nikki-uwu/Meower/info_and_docs/bci-timeline-complete-part2.md

## 16-Channel EEG Acquisition System Development

### Topic Definitions

1. **Hardware Selection** - Component evaluation, chip selection, module comparison
2. **Analog Front-End** - ADS1299 configuration, registers, daisy-chain operation
3. **PCB Design** - Layout, routing, component placement
4. **Power Management** - TX power control, battery monitoring, power optimization
5. **ESP32 Firmware** - Embedded software, FreeRTOS, SPI drivers, core functionality
6. **DSP** - Digital filters (FIR/IIR), signal processing, real-time algorithms
7. **GUI/Visualization** - Python GUI, plotting, user interface, real-time display
8. **Network/Discovery** - UDP communication, WiFi, auto-discovery protocols
9. **BrainFlow Integration** - VRChatBoard driver development, API integration
10. **Documentation** - README, timeline, knowledge base maintenance
11. **Testing/Debug** - Troubleshooting, bug fixes, validation

---

## Chronological Timeline

| Date | Start | End | Duration | Topic(s) | Work Details |
|---|---|-----|---|---|---|
| 2025-07-11 | 14:02:16 | 16:57:29 | 2h 55m | Documentation, Hardware Selection | Claude AI workflow comparison, Python merger script, ESP32-C3 EEG board analysis (75% production ready) |
| 2025-07-11 | 19:39:56 | 21:35:04 | 1h 55m | GUI/Visualization | Python visualization debugging - matplotlib blitting issues, amplitude slider, Entry widgets |
| 2025-07-12 | 13:37:01 | 14:43:14 | 1h 6m | GUI/Visualization | Code update guidance, blitting technique with marked dynamic artists |
| 2025-07-12 | 15:50:35 | 18:45:11 | 2h 55m | GUI/Visualization | GUI plot duration updates, SignalWorker buffer resizing, StringVar/Entry desync fix, code rules |
| 2025-07-12 | 22:25:34 | 23:58:31 | 1h 33m | GUI/Visualization, DSP | Signal amplitude 3.17x (6dB PGA gain), optimized 24-bit parser vectorization |
| 2025-07-13 | 00:01:51 | 01:03:19 | 1h 1m | GUI/Visualization | PlotManager extraction from monolithic main_gui.py (1800→850 lines) |
| 2025-07-13 | 16:25:39 | 19:17:20 | 2h 52m | GUI/Visualization, DSP | NFFT power-of-2 removal, max-hold feature, time delta plot (8μs timestamps) |
| 2025-07-13 | 21:10:20 | 22:33:35 | 1h 23m | GUI/Visualization | Channel selector wavelets/spectrogram, 95% overlap, power limit sliders |
| 2025-07-14 | 00:04:02 | 00:13:01 | 0h 9m | GUI/Visualization | NERV/Evangelion aesthetic redesign - amber on black |
| 2025-07-14 | 07:59:01 | 08:38:48 | 0h 40m | GUI/Visualization | Semi-transparent orange panels, borderless entries, gradient sliders |
| 2025-07-14 | 13:50:43 | 14:10:07 | 0h 19m | GUI/Visualization | Fixed ttk widget bg errors, GradientScale implementation |
| 2025-07-15 | 01:03:36 | 03:56:51 | 2h 53m | GUI/Visualization, Analog Front-End | Signal slider colors, IIR filter states, DC filtering, ADS1299 slave registers |
| 2025-07-15 | 13:33:15 | 15:09:51 | 1h 37m | BrainFlow Integration | VRChatBoard implementation, config_board(), debug mode, auto-discovery |
| 2025-07-15 | 18:20:40 | 19:53:49 | 1h 33m | BrainFlow Integration, Network/Discovery | Auto-discovery beacons, UDP socket port 5000 binding fix |
| 2025-07-16 | 17:54:38 | 23:27:07 | 5h 33m | BrainFlow Integration, GUI/Visualization | Debug message removal, thread safety, ASCII cleanup, real-time plotting 1-sec window |
| 2025-07-17 | 00:00:34 | 00:36:36 | 0h 36m | BrainFlow Integration | Python debugging config, BoardShim.enable_dev_board_logger() |
| 2025-07-17 | 02:53:09 | 07:44:01 | 4h 51m | BrainFlow Integration | Timestamp channel, keep-alive mechanism, thread management, fallback settings |
| 2025-07-18 | 02:41:26 | 07:30:07 | 4h 49m | BrainFlow Integration, DSP | ESP32 board integration, UDP frame parsing, digital filter state reset |
| 2025-07-18 | 08:28:43 | 11:48:24 | 3h 20m | Documentation | Git submodule strategy, pip installation from GitHub |
| 2025-07-19 | 18:15:15 | 18:16:40 | 0h 1m | Hardware Selection | 16-channel EEG board market research |
| 2025-07-19 | 19:06:38 | 23:48:16 | 4h 42m | ESP32 Firmware, Network/Discovery | ESP32 data acquisition review, MEOW_MEOW/WOOF_WOOF protocol, auto IP |
| 2025-07-19 | 23:52:02 | 23:57:33 | 0h 6m | ESP32 Firmware | Auto IP discovery final verification |# BCI Project Complete Timeline
| 2025-07-20 | 00:25:10 | 00:27:09 | 0h 2m | Documentation | GitHub repository privacy settings |
| 2025-07-20 | 17:03:15 | 17:14:57 | 0h 12m | ESP32 Firmware | "floof" references cleanup to "WOOF_WOOF" |
| 2025-07-21 | 02:54:06 | 07:57:02 | 5h 3m | Hardware Selection, Documentation | BCI market analysis, OpenBCI sales, profit calculations |
| 2025-07-21 | 23:57:36 | 23:57:54 | 0h 0m | Testing/Debug | SPI message generation script |
| 2025-07-22 | 00:05:43 | 00:22:23 | 0h 17m | Analog Front-End | SPI message format, ADS1299 ID register values |
| 2025-07-22 | 22:17:58 | 22:20:14 | 0h 2m | GUI/Visualization | Serial console IP configuration removal |
| 2025-07-23 | 22:42:44 | 23:37:14 | 0h 55m | Analog Front-End | ADS1299 SPI interface design, daisy-chain register reading |
| 2025-07-24 | 00:01:12 | 02:24:17 | 2h 23m | ESP32 Firmware, Analog Front-End | Adaptive frame packing, linker error fix, code audit |
| 2025-07-24 | 02:26:10 | 04:22:27 | 1h 56m | ESP32 Firmware | SPI clock management, USR commands, signal graph updates |
| 2025-07-24 | 09:32:26 | 09:39:57 | 0h 8m | Documentation | ESP32-C3 EEG firmware artifacts creation |
| 2025-07-24 | 18:42:55 | 19:37:41 | 0h 55m | Documentation | Documentation refinement, README/KB updates |
| 2025-07-24 | 21:32:36 | 23:55:31 | 2h 23m | ESP32 Firmware, Analog Front-End | USR commands implementation, ADC sampling frequency control |
| 2025-07-25 | 00:00:53 | 01:12:25 | 1h 12m | ESP32 Firmware, Analog Front-End | Hardware PGA gain control, channel power control |
| 2025-07-25 | 10:35:00 | 12:54:04 | 2h 19m | ESP32 Firmware, Documentation | Messages_lib optimization, helper functions, licensing strategy |
| 2025-07-25 | 20:25:05 | 21:47:13 | 1h 22m | Documentation | Open source licensing implementation, project verification |
| 2025-08-07 | 00:49:13 | 02:44:36 | 1h 55m | GUI/Visualization | Tkinter Python 3.11/3.12 compatibility, Entry widget sync |
| 2025-08-07 | 05:53:57 | 08:13:05 | 2h 19m | GUI/Visualization, ESP32 Firmware | Window grab issues, dependency verification, board startup analysis |
| 2025-08-07 | 10:48:16 | 13:06:49 | 2h 19m | ESP32 Firmware, Power Management | WiFi TX power ramping (2dBm→11dBm), flash erase automation, AP mode |
| 2025-08-07 | 20:19:07 | 23:17:51 | 2h 59m | GUI/Visualization | GUI compatibility, VRCMarker optimization, TimelineController fixes |
| 2025-08-08 | 11:41:33 | 12:12:55 | 0h 31m | BrainFlow Integration | VRChat board logging modification, debug output |
| 2025-08-12 | 05:21:29 | 05:51:30 | 0h 30m | GUI/Visualization | BrainFlow real-time plotting, dual subplot display |
| 2025-08-13 | 01:35:05 | 05:58:21 | 4h 23m | Documentation | BCI timeline recovery, verification, code comparison |
| 2025-08-13 | 05:30:24 | 08:35:24 | 3h 5m | Documentation | ChatGPT JSON compression, timeline extraction strategies |
| 2025-08-13 | 08:06:59 | 08:35:24 | 0h 28m | Documentation | Project timeline recovery analysis (merged with above) |
| 2025-08-18 | 07:17:28 | 07:47:08 | 0h 30m | Documentation | HTML infographic creation, visual calendar fixes |

---

## Summary Statistics

### Total Time by Topic

| Topic | Total Duration |
|---|---|
| GUI/Visualization | 30h 34m |
| Documentation | 24h 30m |
| ESP32 Firmware | 19h 45m |
| BrainFlow Integration | 19h 30m |
| Analog Front-End | 10h 3m |
| DSP | 9h 14m |
| Hardware Selection | 7h 59m |
| Network/Discovery | 6h 15m |
| Power Management | 2h 19m |
| Testing/Debug | 0h 0m |
| PCB Design | 0h 0m |

**Note: Sessions with multiple topics are counted for each topic**

### **ACTUAL TOTAL WORK TIME: 87h 42m**

---

## Key Achievements
- **July 11**: Migration to Claude, 75% production assessment
- **July 13**: PlotManager extraction (clean architecture)
- **July 14**: NERV/Evangelion GUI theme
- **July 15**: BrainFlow VRChatBoard driver
- **July 19**: MEOW_MEOW/WOOF_WOOF protocol
- **July 24-25**: Complete USR command family
- **August 7**: WiFi TX power ramping fix (2→11dBm)
- **August 13**: Complete timeline recovery

### Issues Status
1. **UDP dropout race** - Still present
2. **Timestamp rollover (9.5h)** - Not fixed
3. **Filter Q=35** - Fixed
4. **WiFi TX oversaturation** - Fixed (Aug 7)
5. **Python 3.11/3.12 compatibility** - Fixed
6. **BrainFlow upstream merge** - Pending

### Production Readiness: 85%
