nikki-uwu/Meower/info_and_docs/eeg-firmware-knowledge-base.md

# ESP32-C3 EEG Firmware Complete Knowledge Base

This document consolidates ALL technical knowledge, implementation details, and important notes scattered throughout the firmware codebase. Created to prevent getting lost in the massive codebase.

---

## 🔴 Critical Safety & Performance Rules

1. **ALWAYS use battery power during recording** - USB introduces catastrophic noise that destroys µV-level signals
2. **Never exceed 2 MHz SPI during initial configuration** - ADS1299 refuses faster clocks after reset
3. **Keep ADC sense pin on ADC1 only** - ADC2 conflicts with WiFi and will cause crashes
4. **Quad-tap power for recovery** - If board acts dead, 4 power cycles < 5s cumulative triggers captive portal
5. **Send "WOOF_WOOF" every ≤10 seconds** - Board drops to IDLE after 10s without keep-alive
6. **SPI/USR commands stop streaming** - Any SPI or USR command via WiFi immediately stops continuous mode because ADS1299 can't receive register commands during continuous data mode

---

## 1. Hardware Architecture & Pin Mapping

### ESP32-C3 Pin Assignments
```
SCLK        : GPIO 10  (Hardware SPI)
MOSI        : GPIO 6   (Hardware SPI)
MISO        : GPIO 2   (Hardware SPI + pulldown to prevent tri-state decay)
DRDY        : GPIO 3   (Interrupt pin, FALLING edge)
START       : GPIO 0   (Controls ADC sampling)
PWDN        : GPIO 8   (Power down control)
RESET       : GPIO 7   (Hardware reset)
CS_MASTER   : GPIO 1   (Master ADS1299)
CS_SLAVE    : GPIO 5   (Slave ADS1299)
CS_UNUSED   : GPIO 21  (Default SPI CS - kept HIGH)
LED         : GPIO 20  (Status indicator, active LOW)
BAT_SENSE   : GPIO 4   (ADC1_CH4 - CRITICAL: Must be ADC1!)
```

### Daisy-Chain Configuration
- **Data flow**: Slave ADC output → Master ADC input → ESP32
- **Clock**: Master provides clock to Slave via dedicated line
- **Sync**: Both ADCs share START signal for perfect alignment
- **Frame structure**: 27 bytes per ADC (3 preamble + 24 channel data)

### Electrical Design Notes
- **Battery voltage divider**: Calibrated scale factor = 0.001235 (current implementation)
- **Battery monitoring**: Sampled every 32ms with IIR filter (α=0.05) for stable readings
- **Pull-down on MISO**: Prevents signal decay when last bit = 1
- **CS timing**: Uses direct register writes (40ns edges) vs digitalWrite (1.2µs)
- **Power**: ~400mW typical, 470mW max @ 4kHz
- **PGA Gain**: Voltage amplification in analog domain before ADC conversion
- **DC Offset Warning**: Check DC voltage between input pins before setting gain - small signals on DC offsets will saturate when amplified
- **Data format**: Channel data in big-endian, timestamps and battery voltage in little-endian
- **CPU locked to 160MHz**: At 80MHz there's not enough headroom for 4kHz processing despite only +30mW difference

### TX Power Management
- **Initial power**: Starts at 2dBm to prevent RF oversaturation during initialization
- **Operational power**: Increases to 11dBm for normal operation after WiFi/AP setup
- **Sequence**: Low power → Initialize → Configure → Increase to operational level

---

## 2. Boot Sequence & Recovery Mechanisms

### BootCheck System (Anti-Brick Protection)
```
Window: 5 seconds cumulative ON time
Detection: 3 reboots with flag="a" (armed) within window
Action: Set BootMode="AccessPoint" → force captive portal
Reset: After 1 second, flag changes "a"→"b" (disarmed)
```

### Captive Portal Emergency Mode
- **SSID**: `EEG-SETUP`
- **Password**: `password`  
- **IP**: `192.168.4.1`
- **Saves to NVS**: ssid, pass, port_ctrl, port_data
- **Auto-triggers**: On missing config or boot storm

### ADS1299 Initialization Sequence
1. Set continuous mode OFF
2. Force SPI to 2 MHz (CRITICAL for stability)
3. All digital signals LOW (CS, START)
4. PWDN/RESET cycle with 150ms delays
5. Send RESET pulse (10µs LOW)
6. SDATAC command (exit continuous mode)
7. Enable internal reference (CONFIG3 = 0xE0)
8. Configure master clock output to slave
9. **Wait 50ms for slave clock lock** - CRITICAL: Slave ADC needs time to lock onto master's clock signal
10. Enable test signal (1Hz square wave)
11. Board initializes at 250 Hz with 5-frame packing (50 packets/sec)
12. SPI remains at 2 MHz until `sys start_cnt` switches to 16 MHz
13. **Default channel settings**:
    - Normal mode: Test signal input, gain = 1x (register value 0x05)
    - BCI mode: Normal electrode input with SRB2, gain = 1x (register value 0x08)

### Readiness Check
```c
// Loop until ADS1299 responds with correct ID
while (true) {
    xfer('M', 3, {0x20, 0x00, 0x00}, rx);  // Read register 0x00
    if (rx[2] == 0x3E) break;               // Expected device ID
    delay(10);
}
```

---

## 3. Network Architecture & Lifecycle

### State Machine
```
DISCONNECTED → (WiFi connect) → IDLE → (start_cnt) → STREAMING
     ↑              ↑                        ↓
     └──────────────┴──── (timeout/stop) ───┘
```

### Discovery & Keep-Alive Protocol
1. **Board broadcasts**: "MEOW_MEOW" (9 bytes) to 255.255.255.255 on control port every 1 second when no PC found
2. **PC responds**: Sends "WOOF_WOOF" to board's IP on control port
3. **Board captures PC IP**: First WOOF_WOOF saves source IP as PC address
4. **Keep-alive required**: PC must send "WOOF_WOOF" every <10 seconds to maintain connection
5. **Connection lost**: If no WOOF_WOOF for 10 seconds, board drops to IDLE and restarts MEOW_MEOW broadcasts

**Notes**:
- Control port is configurable (default 5000)
- Board ignores its own MEOW_MEOW echoes
- Any valid packet refreshes watchdog (WOOF_WOOF, commands) except MEOW_MEOW echoes
- Keep-alive is "WOOF_WOOF" (no trailing space or other variations)

### Timeout Hierarchy
1. **10s streaming watchdog**: No data → drop STREAMING to IDLE
2. **10s global silence**: No packets at all → restart beacons
3. **60s reconnect limit**: WiFi keeps failing → radio OFF, LED=LOST

### LED Status Codes (250ms on, 5s cycle)
- **Rapid flash**: Network setup mode (AP active)
- **3 blinks**: Cannot connect to WiFi (DISCONNECTED)
- **2 blinks**: Connected but IDLE
- **1 blink**: STREAMING data
- **5 blinks**: Connection LOST (failsafe triggered)

### AsyncUDP Implementation
- **TX**: Traditional WiFiUDP for sending
- **RX**: Event-driven AsyncUDP (zero polling overhead)
- **Queue**: 8-slot command queue, 512 bytes each
- **Beacon filter**: Ignores own MEOW_MEOW beacons

---

## 4. Data Path Architecture

### Frame Structure (52 bytes)
```
[48 bytes ADC data][4 bytes timestamp]
    ↓                    ↓
16 ch × 3 bytes      Little-endian
Big-endian 24-bit    8µs timer units
```

### Packet Structure (max 1472 bytes)
```
[Frame 1][Frame 2]...[Frame N][Battery Voltage]
52 bytes  52 bytes    max 28   4 bytes float32 LE
```

### Task Architecture
1. **DRDY ISR** (IRAM): ~5µs to notify ADC task
2. **ADC/DSP Task** (Priority MAX-1, Core 0):
   - Triggered by task notification (not semaphore - 45% faster)
   - Reads 54 bytes via SPI DMA
   - Strips preambles (saves 6 bytes)
   - Unpacks 24→32 bit with +8 bit headroom
   - Runs DSP pipeline (FIR + IIRs)
   - Packs back to 24-bit
   - Queues complete packet

3. **UDP Task** (Priority MAX-2, Core 0):
   - Blocks on 5-slot queue
   - Appends battery voltage
   - Sends via WiFi

### Queue Design
- **5 slots**: Each holds one complete data packet (up to 28 ADC frames with timestamps)
- **ADC never blocks**: If queue full, skips enqueue and continues processing
- **WiFi headroom**: 5 buffered packets allow WiFi to recover from hiccups without data loss
- **FIFO order**: Guaranteed by FreeRTOS

### Adaptive Packet Sizing

The firmware dynamically adjusts frames per packet to target 50 packets/second over WiFi:

**Hardware Constraints**:
1. **MTU Limit**: 1472 bytes usable → max 28 frames (28*52+4=1460 bytes)
2. **WiFi Timing**: ESP32 needs ~6ms between packets → max ~166 packets/sec
   - This is a hardware/driver limitation of the ESP32 WiFi stack
   - Pushing faster causes packet drops and instability

**Implementation**:
- Lookup table in `FRAMES_PER_PACKET_LUT[5]` maps sampling rate to frame count
- Updated when sampling rate changes in `continuous_mode_start_stop()`
- Variables updated:
  - `g_framesPerPacket`: How many frames to pack
  - `g_bytesPerPacket`: ADC data size threshold  
  - `g_udpPacketBytes`: Total UDP payload size (includes battery)

**Packing Strategy**:
| Rate | Frames | Result |
|---|---|---|
| 250 Hz | 5 | 50 packets/sec |
| 500 Hz | 10 | 50 packets/sec |
| 1000 Hz | 20 | 50 packets/sec |
| 2000 Hz | 28 | 71 packets/sec (MTU limit) |
| 4000 Hz | 28 | 143 packets/sec (MTU limit) |

**Why This Matters**:
- 250 Hz unpacked = 250 pkt/s → WiFi overload
- 250 Hz with 5-frame packing = 50 pkt/s → smooth operation
- 4000 Hz would need 4000 pkt/s unpacked → impossible
- 4000 Hz with 28-frame packing = 143 pkt/s → just under limit

---

## 5. Digital Signal Processing Pipeline

### Overview
All processing runs at 160MHz with fixed-point math. Global enable + individual filter enables.

### Complete Processing Chain (Sequential, In-Place)
```
Input (54 bytes) → [ADC Parse] → [<<8 shift] → [Digital Gain] → [FIR Equalizer] → [DC Blocker] → [Notch 50/60] → [Notch 100/120] → [>>8 shift] → Output (48 bytes)
                      ↓              ↓              ↓                ↓                ↓               ↓                  ↓               ↓
                 Remove preambles  24→32 bits    Bit shift      Optional        Optional        Optional          Optional         32→24 bits
```

### Processing Steps:

1. **ADC Sample Parsing**: Strip two 3-byte preambles from raw 54-byte frame (27 bytes per ADC) to get 48 bytes of channel data

2. **Bit Shift Up (+8)**: Convert 24-bit to 32-bit with 8-bit headroom for DSP

3. **Digital Gain**: Additional bit shifting (0-8 bits) for signal amplification
   - Reduces maximum input range before saturation:
     - Gain 1: ±4.5V (full ADC range)
     - Gain 8: ±562.5mV
     - Gain 16: ±281.25mV

4. **FIR Equalizer (7-tap)**:
   - Purpose: Compensates ADS1299 sinc³ decimation rolloff
   - Response: Flat ±0dB from DC to 0.8×Nyquist
   - Shift: 30 bits output scaling
   - Bypass: True pass-through coefficients

5. **DC Blocker (2nd order Butterworth IIR)**:
   - Cutoffs: 0.5, 1, 2, 4, 8 Hz (runtime selectable)
   - Coefficient sets: 25 (5 sample rates × 5 cutoffs)
   - Note: 0.5Hz cutoff @ 4kHz sampling can become unstable (resonator behavior)

6. **Notch Filters (4th order, cascaded biquads)**:
   - 50/60 Hz: Q≈35, -40dB rejection (NOT Q=50 as sometimes incorrectly stated)
   - 100/120 Hz: Same specs for harmonics
   - Coefficient sets: 10 each (5 rates × 2 regions)

7. **Bit Shift Down (-8)**: Convert back from 32-bit to 24-bit for transmission

### Filter Math Details
- **Data type**: int32_t[16] throughout
- **Signal scaling**: All signals get +8 bit shift (24→32 bits) to occupy more of the dynamic range for filter precision
  - This is fixed 8-bit shift, not adaptive scaling
  - Critical for filter stability at extreme settings (0.5Hz @ 4kHz)
  - Without this, filters can break and add DC instead of removing it
- **Rounding**: Away from zero to prevent DC bias
- **Headroom**: All stages stay within ±31 bits
- **Reset**: Toggle off→on clears IIR states (takes ~9 samples for full clear due to filter depth)
- **Coefficient generation**: Python script included as comments in math_lib.h

### Important IIR Filter Behavior
**Problem**: Large spikes can cause ringing (phantom oscillations)
**Solution**: `sys filters_off` → `sys filters_on` resets states
**Timing**: State reset is immediate, but takes ~9 samples for complete clear due to filter depth

### Runtime Filter Control
- **SYS commands work during streaming**: Filters toggle in real-time without stopping data
- **Filter changes are immediate**: No need to stop/restart streaming
- **Each filter has individual control**: Can enable/disable specific filters while others run

---

## 6. SPI Communication Layer

### Clock Management (CENTRALIZED)

**Critical**: `continuous_mode_start_stop()` is the **ONLY** function that:
- Changes SPI clock speeds (2 MHz ↔ 16 MHz)
- Controls continuous mode state (START signal + RDATAC/SDATAC commands)
- Ensures proper state for all register operations

**Clock States**:
```c
Configuration: 2 MHz (when continuousReading == false)
Streaming:     16 MHz (when continuousReading == true)
Mode:          SPI_MODE1 (CPOL=0, CPHA=1)
```

**Why Different Speeds?**:
- **2 MHz for configuration**: ADS1299 register operations become unstable above 4 MHz
- **16 MHz for streaming**: Maximum stable speed for continuous data transfer

**Clock Invariant**: All functions can assume the correct clock is already set based on continuous mode state

### Chip Select Control
- **Method**: Direct register writes via WRITE_PERI_REG
- **Timing**: 40ns edges (vs 1.2µs for digitalWrite)
- **Sync**: Both CS lines toggle simultaneously
- **Delays**: 2µs after CS LOW, 2µs before CS HIGH

### Critical Transfer Function
```c
void xfer(target, length, txData, rxData) {
    portENTER_CRITICAL();      // Block ALL interrupts
    cs_both_high();            // Ensure clean state
    
    switch(target) {
        'M': cs_master_low();  // Master only
        'S': cs_slave_low();   // Slave only  
        'B': cs_both_low();    // Both ADCs
        'T': break;            // Test mode (no CS)
    }
    
    esp_rom_delay_us(2);       // ≥4 SPI clocks
    transferBytes();           // DMA burst
    esp_rom_delay_us(2);       // ≥4 SPI clocks
    cs_both_high();            // Deselect
    portEXIT_CRITICAL();
}
```

### Daisy-Chain Register Reading
Reading registers from both ADCs simultaneously is implemented via `read_Register_Daisy()`:
- Uses target 'B' (both chips selected)
- Sends 30-byte transaction
- Master register value at byte 3
- Slave register value at byte 30
- **Used internally by usr commands** but not exposed as simple SPI command
- **usr gain/ch_power_down/ch_input/ch_srb2 commands** all use this internally when targeting specific channels

### Daisy-Chain Register Read Protocol

In daisy-chain mode, reading registers requires special handling because both ADCs are connected in series. The slave's data output feeds into the master's data input, and the ESP32 only reads from the master.

**Why 30 bytes?**
When reading a single register in daisy-chain mode:
- Each ADC outputs 27 bytes total (3 header bytes + 24 channel data bytes)
- For register reads, only the 3rd byte of each ADC's response contains the actual register value
- Master's register value appears at byte position 3 (0-indexed: rx[2])
- Slave's register value appears at byte position 30 (0-indexed: rx[29])
- We only need to clock out 30 bytes to retrieve both register values

**Protocol Requirements**:
1. **Must select both chips simultaneously** - Using target 'B' is mandatory. If only one chip is selected, the daisy chain breaks and data becomes corrupted
2. **Must use configuration clock** (2 MHz) - ADS1299 requires slower clock for register operations
3. **Cannot read different registers** from each ADC in one transaction - both receive the same command
4. **Response order is fixed** - Slave data always arrives first, then Master data
5. **Timing is critical** - The 2µs delays after CS changes ensure proper setup/hold times

---

## 7. Command Protocol

### Format
- **Transport**: UDP port 5000 (default)
- **Encoding**: UTF-8 strings
- **Termination**: Not required (packet boundary)

### Command Safety
**Command Behavior During Continuous Mode**:
- **SYS commands**: Execute without interrupting data flow. Filters, digital gain, network settings update in real-time
- **SPI and USR commands**: Automatically stop continuous mode before executing because:
  - ADS1299 cannot receive register commands during continuous data mode (RDATAC)
  - Must exit to command mode (SDATAC) first
  - Requires 2 MHz clock for stable register operations
- **Clock Speed Rationale**: Register operations above 4 MHz unstable, streaming uses 16 MHz for throughput

### System Commands (Can be used during continuous mode)
```
sys start_cnt         Start streaming
sys stop_cnt          Stop streaming
sys adc_reset         Full ADC reset + sync (stops continuous mode)
sys esp_reboot        Complete reboot (stops continuous mode)
sys erase_flash       Wipe config → AP mode (stops continuous mode)

sys filters_on/off    Master filter switch (real-time)
sys filter_equalizer_on/off  (real-time)
sys filter_dc_on/off        (real-time)
sys filter_5060_on/off      (real-time)
sys filter_100120_on/off    (real-time)

sys networkfreq 50|60       (real-time)
sys dccutofffreq 0.5|1|2|4|8  (real-time)
sys digitalgain 1|2|4|8|16|32|64|128|256  (real-time)
```

### User Commands (Stop continuous mode before executing)
```
usr set_sampling_freq 250|500|1000|2000|4000
usr gain <channel|ALL> <1|2|4|6|8|12|24>
usr ch_power_down <channel|ALL> <ON|OFF>
usr ch_input <channel|ALL> <input_type>
usr ch_srb2 <channel|ALL> <ON|OFF>
```

**Channel-specific commands**:
- Channel numbers: 0-15 (0-7 on Master, 8-15 on Slave)
- ALL: Applies to all 16 channels
- Commands automatically route to correct ADC based on channel number
- Internal implementation uses `read_Register_Daisy()` for verification

### SPI Commands (Stop continuous mode before executing)
```
spi M|S|B|T <len> <byte0> <byte1> ...
M=Master, S=Slave, B=Both, T=Test
Max 256 bytes per transaction
```

---

## 8. Performance & Optimization Notes

### CPU & Power
- **CPU locked**: 160MHz (only +30mW vs 80MHz but huge headroom)
- **Power**: 400mW @ 250Hz, 470mW @ 4kHz
- **Battery**: 10+ hours on 1100mAh LiPo

### Critical Timing
- **DRDY ISR**: <15µs max (IRAM placement)
- **CS edges**: 40ns (register writes)
- **Context switch**: ~5µs when ADC task wakes

### Memory & Queues
- **Stack sizes**: ADC task 2048B, UDP task 2048B
- **Queue depth**: 5 slots, each slot size varies by sampling rate
- **Packet size**: Adaptive (264-1460B based on sampling rate)
- **Buffer allocation**: Max size (1460B + 4B battery) to handle all rates
- **Blocking behavior**:
  - ADC/DSP task: NEVER blocks - skips enqueue if queue full
  - Data TX task: Blocks waiting for data (normal producer-consumer)

### WiFi Power Optimization
```c
WiFi.setSleep(true);               // Modem sleeps between DTIM beacons
cfg.sta.listen_interval = 1;       // Wake every beacon interval
esp_wifi_set_ps(WIFI_PS_MAX_MODEM); // Deepest power-save mode
```
- Allows WiFi modem to sleep between packets
- Significantly reduces idle power consumption
- No impact on streaming performance

### Optimization Tricks
- **Task notifications**: 45% faster than semaphores
- **Direct register IO**: 30x faster than digitalWrite
- **DMA transfers**: Cleaner edges than byte loops
- **Fixed-point DSP**: Consistent timing, no float variance
- **Adaptive packing**: Single volatile read adds ~1-2 CPU cycles (12ns @ 160MHz)
- **Digital gain usage**: Helps occupy full 32-bit range for filter precision, not just visualization

---

## 9. Utility Functions & Helpers

### safeTimeDelta()
```c
// Prevents -1 underflow if ISR updates timestamp mid-calculation
return (now >= then) ? (now - then) : 0;
```
**Race condition**: When checking timeouts, code reads millis() then compares to lastRxMs. If WiFi ISR updates lastRxMs between these operations, the subtraction underflows to 0xFFFFFFFF. This function returns 0 instead of -1, preventing false timeouts.

### Battery_Sense Class
- **IIR filter**: α=0.05 default (20x jitter reduction)
- **Period**: 32ms sampling interval
- **Scaling**: Hardware-specific calibration factor (0.001235)

### Blinker Class
- **Zero-cost**: Only writes on state changes
- **Patterns**: Burst mode (N flashes per period)
- **Polarity**: Handles active-high or active-low

### Serial CLI
- **Purpose**: WiFi configuration and basic control
- **Available commands**: set ssid/pass/port_ctrl/port_data, show, apply
- **Works at runtime**: Can reconfigure while board is running
- **Debug output**: Available with SERIAL_DEBUG=1 in defines.h

---

## 10. Python GUI & Integration

### GUI Features
- **Real-time visualization**: Time-domain, wavelet, spectrogram, PSD plots
- **Channel controls**: Per-channel visibility toggles
- **NERV/Evangelion theme**: Custom visual styling
- **60fps updates**: Optimized matplotlib with blitting

### Setup
- **Dependencies**: Run `python install_dependencies.py` or use requirements.txt
- **Required packages**: numpy, scipy, matplotlib, pyserial
- **Python version**: 3.11+ recommended

### BrainFlow Integration
- **Status**: Implemented but not merged into official BrainFlow
- **Branch**: Available in separate branch [MUSTUPDATE: August 13, 2025]
- **Driver**: Custom BoardShim implementation for Meower board

---

## 11. Known Issues & Workarounds

### Current Issues
- **UDP dropout race condition**: May cause occasional data loss (unresolved)
- **Timestamp rollover**: After 9.5 hours (8µs timer wraps at 2^32)
- **BootCheck complexity**: Overly complex, hardware button would be simpler

### Quirks to Remember
- **WiFi + ADC2** = instant crash (hardware limitation)
- **USB ground loops** = unusable data (physics problem)
- **IIR at 0.5Hz/4kHz** = potential instability (use higher digital gain to help)
- **Python lacks arithmetic shift** = manual sign extension needed
- **DC offset on inputs** = Check with multimeter before amplifying
- **Unused channels** = Power down AND short inputs using `ch_input SHORTED`

### Debug Features
- **SERIAL_DEBUG**: Set to 1 in defines.h for verbose output
- **Test mode 'T'**: Sends SPI clocks without CS for scope

---

## Quick Command Reference Card

```bash
# Start recording
sys start_cnt

# Stop recording  
sys stop_cnt

# Change sampling rate (stops streaming)
usr set_sampling_freq 1000

# Set channel gains (stops streaming)
usr gain 5 24       # Channel 5 to 24x gain
usr gain ALL 4      # All channels to 4x gain

# Channel power control (stops streaming)
usr ch_power_down 5 OFF    # Power down channel 5
usr ch_power_down ALL ON   # Power on all channels

# Channel input selection (stops streaming)
usr ch_input 5 SHORTED     # Short channel 5 inputs
usr ch_input ALL NORMAL    # All channels to normal input
usr ch_input 0 TEST        # Channel 0 to test signal

# SRB2 reference control (stops streaming)
usr ch_srb2 ALL ON         # Connect all to SRB2 (referenced mode)
usr ch_srb2 5 OFF          # Disconnect channel 5 from SRB2

# Configure unused channels
usr ch_power_down 15 OFF   # Power down
usr ch_input 15 SHORTED    # Short inputs

# Real-time filter control (works during streaming!)
sys filters_on
sys filter_dc_on
sys filter_5060_on
sys networkfreq 60      # US mains
sys dccutofffreq 0.5    # Slow drift removal
sys digitalgain 8       # 8x amplification

# Reset everything
sys adc_reset     # Just ADCs (stops streaming)
sys esp_reboot    # Full system

# Debug
spi M 3 0x20 0x00 0x00  # Read ADC ID
spi M 3 0x25 0x00 0x00  # Read CH1SET register

# Complete unused channel setup example
usr ch_power_down 14 OFF   # Power down channel 14
usr ch_input 14 SHORTED    # Short its inputs
usr ch_power_down 15 OFF   # Power down channel 15  
usr ch_input 15 SHORTED    # Short its inputs
```

---
