nikki-uwu/Meower/hardware/meower_Active_Electrode_V1/SCH_BCI_ACTIVE_ELECTRODE_2026-03-26.pdf

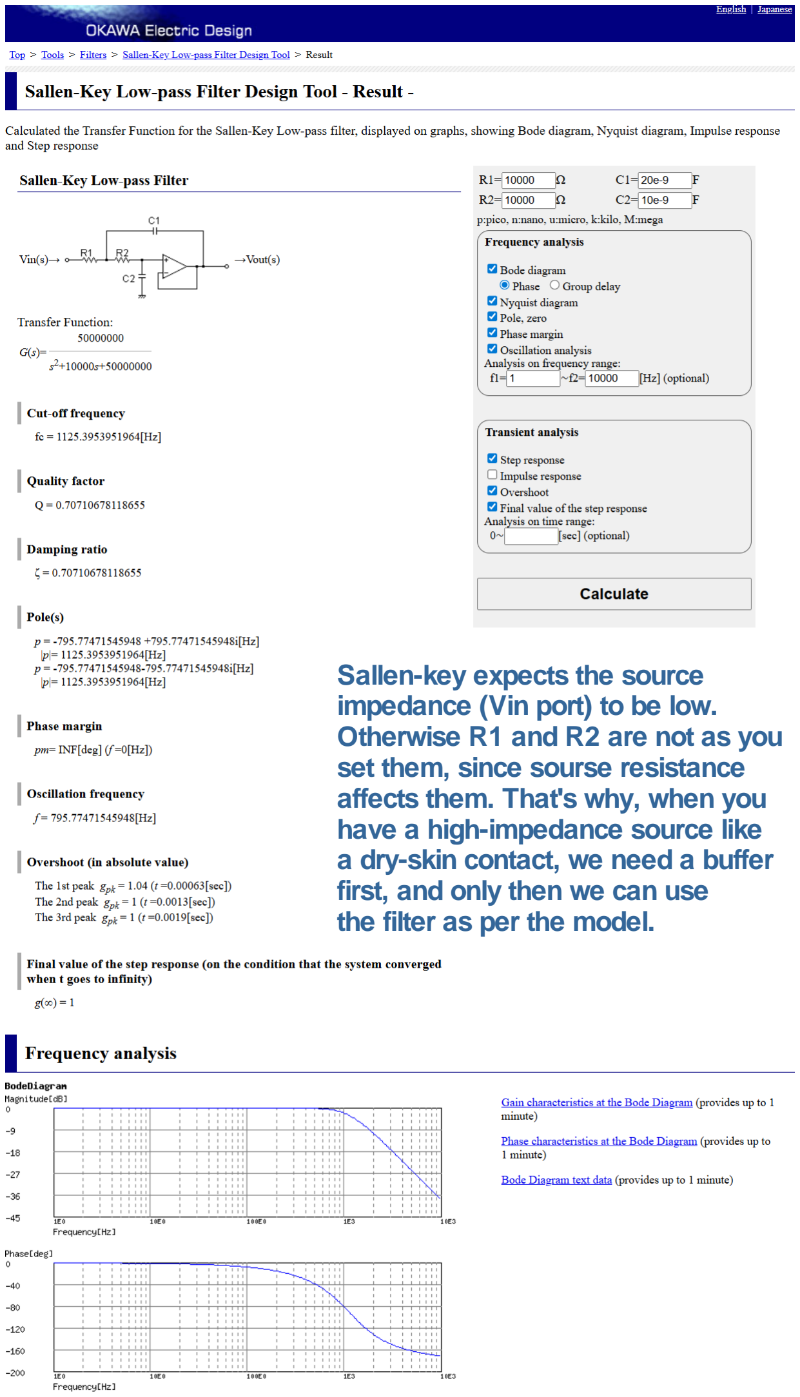
[picture p9: figure]
Sallen-key expects the source impedance (Vin port) to be low. Otherwise R1 and R2 are not as you set them, since sourse resistance affects them. That's why, when you have a high-impedance source like a dry-skin contact, we need a buffer first, and only then we can use the filter as per the model.
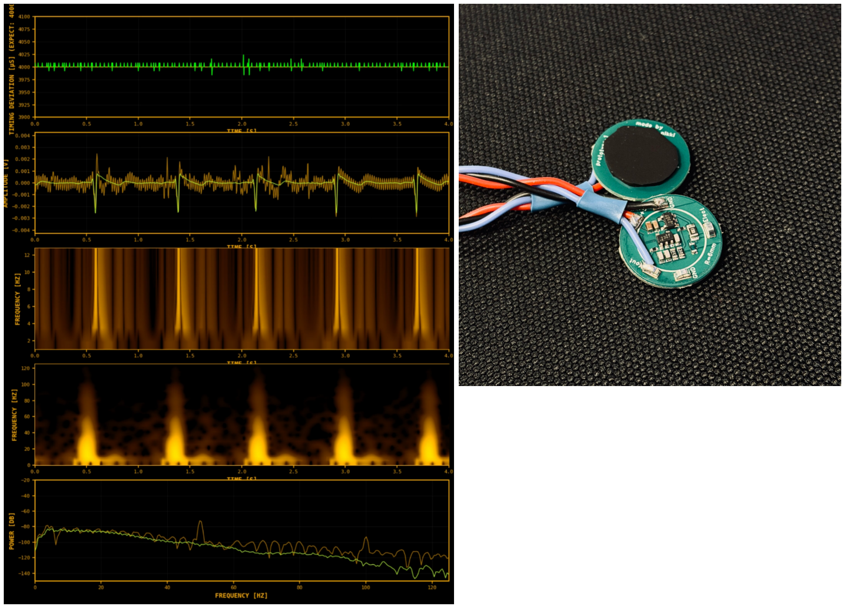
[picture p10: figure]

## nikki_active_electrode_1.1

1

## 2026-03-26 BCI_ACTIVE_ELECTRODE

1

Unity Gain OP-amp / Buffer / Voltage follower

V1.1 | A4 | Designed by --nikki--

1

Reviewed

Drawn

VER

Create Date
Part Number
PAGE | OF

Schematic

Update Date

SIZE

Page

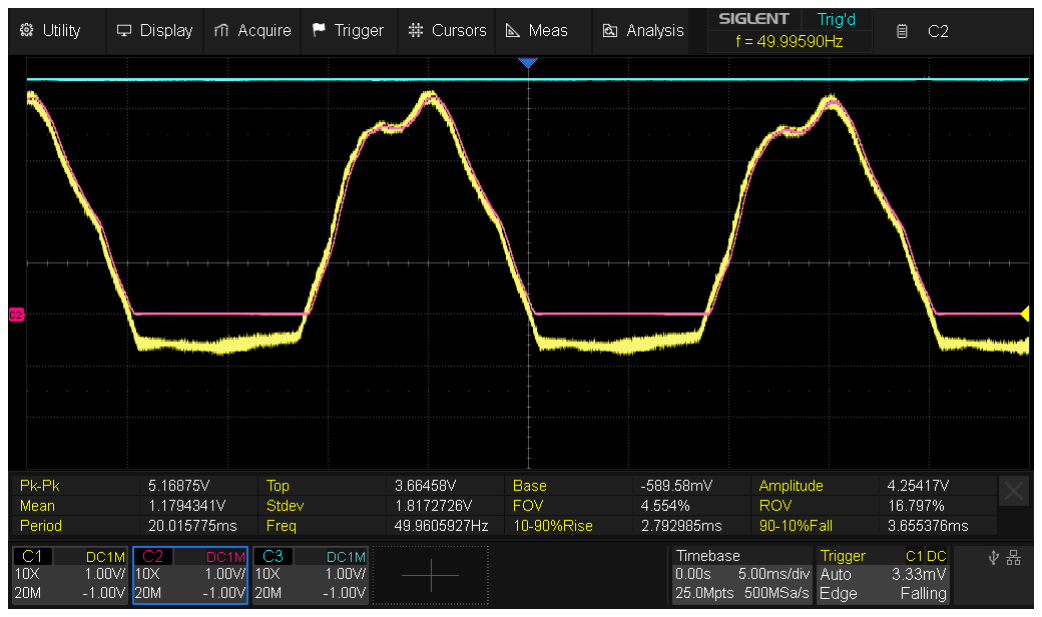
[picture p11: figure]

1
3

4

2 5
U1
ELECTRODE | OPA392DBVR

Common practice is about 10 kOhm per lead to help pass defibrillation and safety tests; we use R4 = 100 kOhm for
margin. This helps limit surge and fault current but
does not replace 60601-1 isolation and leakage limits.

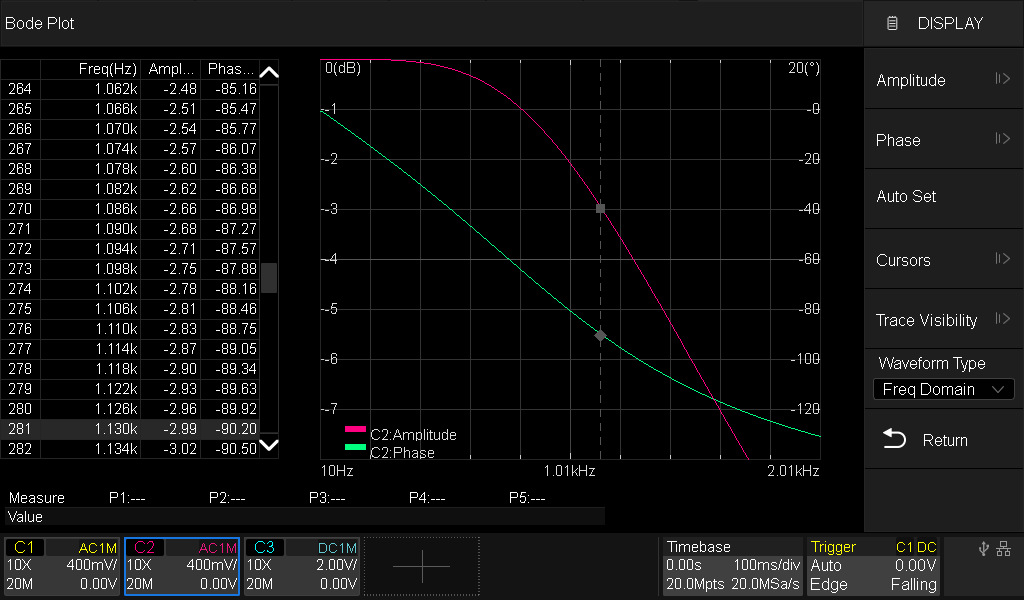
[picture p12: figure]

C4
10uF

C5
100nF

VOUT

R3
100

+5V
Bypass caps
You need them to filter out noise on your power line.
Put as close to power pins (+V) as possible, provide good connection to the ground pin (-V)

R3 is called decoupling or isolation resistor. It's placed after the feedback node and shields the loop from cable or RC capacitance so the amp stays stable by restoring phase margin and preventing overshoot or oscillations. It's used in modularEEG and "Active Eletrode" examples i found.

Sallen-key LPF

R1=R2
C1+C2=C3
Fc~1225 Hz
Q~0.707
Fosc~796 Hz
We are using Low Pass Filter (LPF) just to get rid of any noise above 1.2 kHz or so. We dont really need it, but there is no useful signal above that frequency for us anyway. So we just precondition signal a little bit.
Capacitors are the same because this was the esiest way to get 1% precision caps and exact 2 times ratio for Sallen-Key (i.e. C_feedback = 2 x C_ground). So upper pair just makes one cap which is 2 times bigger than lower one. Remember, nominals will give errors, but our CUTOFF frequency is almost 5 times higher than we need, so we know filter properties will varry, but
for the 0 - 200 Hz range it will probably stays very much as
we planned - unity gain, flat and with the nice phase.

C1 10nF

C2 10nF

C3
10nF

R1
10k

R2
10k

D1
PGB1010603NR

A bidirectional low capacitance TVS from electrode to GND clamps IEC 61000-4-2 ESD at the entry point.
Pick ultra low C and low leakage so it does not load
the microvolt signal and supports 60601-1-2 EMC immunity.

BOARD NEEDS 3 WIRES:
+5V
GND
VOUT (Signal)

Do not connect anything to -IN except the short trace to Vout; take signals only from Vout pin, because -IN is the sensitive summing node and any extra trace or capacitance there can steal phase margin and make the buffer ring.

-IN / PIN 4 remark

Pick an AEC-Q200
"anti-surge/high-power"
( 0.25 0.5 W)

1
3

4

2 5
U2

OPA392DBVR

+5V_CLEAN

Buffer / Voltage-Follower
First op-amp converts high-impedance source to low-impedance output, copying the input signal to allow the Sallen-Key low-pass filter to function properly, since the Sallen-Key requires low source impedance to prevent it (sourse impedance) from adding to R1 and changing the filter's designed cutoff frequency and damping characteristics.

+5V_CLEAN

+5V_CLEAN

BOARD WILL WORK ONLY IF BIAS ELECTRODE DRIVES BODY TO ADC MIDPOINT (~2.25V in case of unipolar ADS1299).

## ADC GROUND = OP-AMP GROUNDs = SIGNAL GROUND ADC +5V = OP-AMPs +5V

Driven Shield (via R5 resistor)
I feel like almost every sourse i found is saying the same thing - you better to use output of the buffer (in our case it's the first op-amp) as pour on
the board upper layer AROUND the electrode input and upto input of
first OP-amp AND as a guard ring at the bottom layer around the electrode. So you are covering high-impedance traces and components. If at the bottom you have only electrode and nothing else close to it - you can skip the ring, but again, upper layer still need driven guard.
I've asked claud and chatGPT to make a statment and the closest one i like sounds like this:
First buffer Vout (through 100 current-limiting resistor) actively drives PCB shield pours and guard ring to signal potential, eliminating parasitic capacitance and preventing capacitive coupling to ground.

DRIVEN_SHIELD

R5
100

R4
100k

# THIS IS A PROTOTYPE! also! from a RANDOM nikki from internet! DO NOT TRUST ME BLINDLY! I will test it and provide info, but please take care of safety and keep

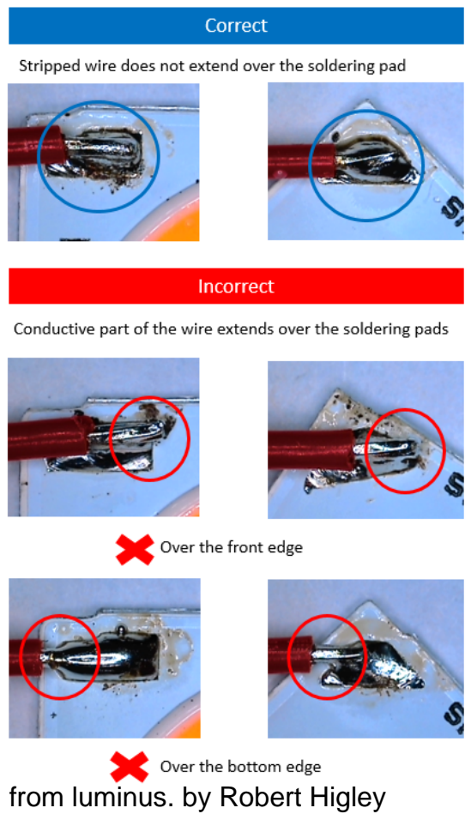
[picture p13: figure]
from luminus. by Robert Higley

in mind - if you short it on yourself it can be a pretty bad experience. When you solder, solder WELL - part of insulation is on the board,
no blobs, wire length is up to pad size and centered (check pictures, pictures are not mine, added ref).
You can solder 5V and ground together with sides of the caps - it's ok.

# But it must be clean. if you attach wires to the loops - make sure it's

tight and clean.

# NO NAKED WIRES OR PARTIALY EXPOSED ENDS SHOULD

EVER HANG FROM THE BOARD.

## OscarLiang.com
