nikki-uwu/Meower/hardware/meower_testing_board_V1/2025_05_24_testing_board_order_files/BOM_CK-C3-Mini-085-4LY_PCB3_2025-05-24.xlsx

No. | Quantity | Comment | Designator | Footprint | Value | Manufacturer Part | Manufacturer | Supplier Part | Supplier
1 | 56 | 2.54-1*1P针 | P2,P30,P31,P32,P33,P34,P35,P36,P37,P38,P39,P40,P41,P42,P43,P44,P45,P46,P47,P48,P49,P50,P51,P52,P53,P54,P55,P56,P57,P58,P59,P60,P61,P62,P63,P64,P65,P66,P67,P68,P69,P70,P71,P72,P73,P74,P75,P76,P77,P78,P79,P80,P81,P82,P83,P84 | HDR-TH_1P-P2.54-V-M |  | 2.54-1*1P针 | BOOMELE(博穆精密) | C81276 | LCSC
2 | 41 | BWCD-L5.0W2.0H2.5 | U17,U18,U19,U20,U21,U22,U23,U24,U25,U26,U27,U28,U29,U30,U31,U32,U33,U34,U35,U36,U37,U38,U39,U40,U41,U42,U43,U44,U45,U46,U47,U48,U49,U50,U51,U52,U53,U54,U55,U56,U57 | CONN-SMD_BWCD-L5.0W2.0H2.5 |  | BWCD-L5.0W2.0H2.5 | BAT WIRELESS(蝙蝠无线) | C2826549 | LCSC
