nikki-uwu/Meower/hardware/meower_Active_Electrode_V1.1/BOM_nikki_active_electrode_2026-03-31.xlsx

No. | Quantity | Comment | Designator | Footprint | Value | Manufacturer Part | Manufacturer | Supplier Part | Supplier
1 | 3 | 10nF | C1,C2,C3 | C0603 | 10nF | GRM1885C1H103FA01D | muRata(村田) | C5299898 | LCSC
2 | 1 | 10uF | C4 | C0603 | 10uF | GRM188Z71A106MA73D | muRata(村田) | C237435 | LCSC
3 | 1 | 100nF | C5 | C0603 | 100nF | GRM188R71H104KA93D | muRata(村田) | C77055 | LCSC
4 | 1 | PGB1010603NR | D1 | C0603 |  | PGB1010603NR | Littelfuse(美国力特) | C10677 | LCSC
5 | 2 | 10kΩ | R1,R2 | C0603 | 10kΩ | RT0603BRD0710KL | YAGEO(国巨) | C95204 | LCSC
6 | 2 | 100Ω | R3,R5 | C0402 small | 100Ω | RT0402BRD07100RL | YAGEO(国巨) | C705627 | LCSC
7 | 1 | 100kΩ | R4 | R0805 | 100kΩ | 0805W8F1003T5E | UNI-ROYAL(厚声) | C149504 | LCSC
8 | 2 | OPA392DBVR | U1,U2 | SOT-23-5_L2.9-W1.6-P0.95-LS2.8-BL |  | OPA392DBVR | TI(德州仪器) | C3647166 | LCSC
