nikki-uwu/Meower/hardware/meower_V1/2025_05_24_meower_order_files/BOM_BCI_Board_2025-05-24.xlsx

No. | Quantity | Comment | Designator | Footprint | Value | Manufacturer Part | Manufacturer | Supplier Part | Supplier
1 | 2 | ADS1299IPAGR | ADC1,ADC2 | TQFP-64_L10.0-W10.0-P0.50-LS12.0-TL |  | ADS1299IPAGR | TI(德州仪器) | C476817 | LCSC
2 | 11 | 100nF | C17,C23,C25,C27,C28,C32,C35,C36,C37,C41,C223 | C0603 | 100nF | GRM188R71H104KA93D | muRata(村田) | C77055 | LCSC
3 | 5 | 10uF | C18,C26,C38,C39,C222 | C0603 | 10uF | GRM188R61A106KE69D | muRata(村田) | C77044 | LCSC
4 | 10 | 1uF | C19,C20,C22,C24,C29,C30,C31,C34,C40,C42 | C0603 | 1uF | GRM188R61E105KA12D | muRata(村田) | C77046 | LCSC
5 | 2 | 100uF | C21,C33 | C1210 | 100uF | LMK325BJ107MM-T | TAIYO YUDEN(太诱) | C92822 | LCSC
6 | 37 | 4.7nF | C101,C102,C103,C104,C105,C106,C107,C108,C109,C110,C111,C112,C113,C114,C115,C116,C201,C202,C203,C204,C205,C206,C207,C208,C209,C210,C211,C212,C213,C214,C215,C216,CBIAS1,Csrb11,Csrb12,Csrb21,Csrb22 | C0402 small | 4.7nF | GCM155R71H472KA37D | muRata(村田) | C85860 | LCSC
7 | 1 | 4.7uF | C227 | C0603 | 4.7uF | GRM188Z71C475KE21D | muRata(村田) | C389010 | LCSC
8 | 3 | 10uF | C228,C231,C232 | C0603 | 10uF | GRM188Z71A106MA73D | muRata(村田) | C237435 | LCSC
9 | 1 | 22uF | C233 | C0603 | 22uF | GRM187R60J226ME15D | muRata(村田) | C710887 | LCSC
10 | 1 | 120pF | C234 | C0402 small | 120pF | GCM1555C1H121JA16D | muRata(村田) | C161146 | LCSC
11 | 2 | 1.5nF | Cbias3,Cbias4 | C0402 small | 1.5nF | GCM155R71H152KA37D | muRata(村田) | C126533 | LCSC
12 | 1 | 10uF | CP1 | C0603 | 10uF | CL10A106KP8NNNC | SAMSUNG(三星) | C19702 | LCSC
13 | 1 | 100nF | C_adc | C0402 small | 100nF | CL05B104KO5NNNC | SAMSUNG(三星) | C1525 | LCSC
14 | 9 | TPD4E1B06DCKR | D1,D2,D3,D4,D5,D7,D8,D9,D10 | SC-70-6_L2.2-W1.3-P0.65-LS2.1-BL |  | TPD4E1B06DCKR | TI(德州仪器) | C840093 | LCSC
15 | 1 | RB161QS-40T18R | D11 | X2-DFN1006-2_L1.0-W0.6-P0.65-RD |  | RB161QS-40T18R | ROHM(罗姆) | C2837790 | LCSC
16 | 2 | 0467001.NRHF | F1,F2 | F0603 |  | 0467001.NRHF | Littelfuse(美国力特) | C151139 | LCSC
17 | 1 | X6521WR-2x18H-C60D30 | H3 | HDR-TH_36P-P2.54-H-M-R2-C18-S2.54 |  | X6521WR-2x18H-C60D30 | XKB Connection(中国星坤) | C725930 | LCSC
18 | 1 | 470nH | L1 | L1008 | 470nH | DFE201610E-R47M=P2 | muRata(村田) | C269773 | LCSC
19 | 1 | 2.2uH | L2 | L1008 | 2.2uH | DFE252012F-2R2M=P2 | muRata(村田) | C576403 | LCSC
20 | 1 | NH-B2020RGBA-HF | LED1 | LED-ARRAY-SMD_4P-L2.1-W2.1-TL_NH-B2020RGBA |  | NH-B2020RGBA-HF | 国星光电 | C2874116 | LCSC
21 | 1 | XL-1606UWC | LED2 | LED-SMD_L1.7-W0.6-RD |  | XL-1606UWC | XINGLIGHT(成兴光) | C965866 | LCSC
22 | 1 | TP4057-42-SOT26-R | P1 | SOT-23-6_L2.9-W1.6-P0.95-LS2.8-BL |  | TP4057-42-SOT26-R | TOPPOWER(南京拓微) | C12044 | LCSC
23 | 1 | DMG1013T-7 | Q1 | SC-75-3_L1.6-W0.8-P1.00-LS1.6-BR |  | DMG1013T-7 | DIODES(美台) | C96676 | LCSC
24 | 38 | 4.7kΩ | R1,R101,R102,R103,R104,R105,R106,R107,R108,R109,R110,R111,R112,R113,R114,R115,R116,R201,R202,R203,R204,R205,R206,R207,R208,R209,R210,R211,R212,R213,R214,R215,R216,RBIAS5,Rsrb11,Rsrb12,Rsrb21,Rsrb22 | R0402 | 4.7kΩ | RC0402FR-074K7L | YAGEO(国巨) | C105871 | LCSC
25 | 1 | 10kΩ | R8 | R0402 | 10kΩ | 0402WGF1002TCE | UNI-ROYAL(厚声) | C25744 | LCSC
26 | 3 | 2kΩ | RA1,RL1,RL2 | R0402 | 2kΩ | 0402WGF2001TCE | UNI-ROYAL(厚声) | C4109 | LCSC
27 | 1 | 470kΩ | Rb1 | C0402 small | 470kΩ | AR02BTC4703 | Viking(光颉) | C319591 | LCSC
28 | 1 | 107kΩ | Rb2 | C0402 small | 107kΩ | RT0402BRD07107KL | YAGEO(国巨) |  | LCSC
29 | 2 | 36.5kΩ | Rb3,Rb5 | C0402 small | 36.5kΩ | RC0402FR-0736K5L | YAGEO(国巨) | C15011 | LCSC
30 | 1 | 8.25kΩ | Rb4 | C0402 small | 8.25kΩ | RC0402FR-078K25L | YAGEO(国巨) | C185389 | LCSC
31 | 1 | 0Ω | Rb6 | C0402 small | 0Ω | 0402WGF0000TCE | UNI-ROYAL(厚声) | C17168 | LCSC
32 | 2 | 1MΩ | RBIAS1,RBIAS4 | C0402 small | 1MΩ | RC0402FR-071ML | YAGEO(国巨) | C138033 | LCSC
33 | 2 | 5.1kΩ | RD1,RD2 | R0402 | 5.1kΩ | 0402WGF5101TCE | UNI-ROYAL(厚声) | C25905 | LCSC
34 | 1 | 10kΩ | R_adc1 | C0402 small | 10kΩ | 0402WGF1002TCE | UNI-ROYAL(厚声) | C25744 | LCSC
35 | 1 | 47kΩ | R_adc2 | C0402 small | 47kΩ | 0402WGF4702TCE | UNI-ROYAL(厚声) | C25792 | LCSC
36 | 1 | SK-3296S-01-L1 | SW4 | SW-SMD_3P-P1.50_L2.7-W6.6 |  | SK-3296S-01-L1 | XKB Connectivity(中国星坤) | C319020 | LCSC
37 | 1 | ESP32-C3-MINI-1-H4X | U2 | WIFIM-SMD_ESP32-C3-MINI-1 |  | ESP32-C3-MINI-1-H4X | ESPRESSIF(乐鑫) | C41349510 | LCSC
38 | 1 | TPS62821DLCR | U14 | VSON-8_L2.0-W1.5-P0.50-BL |  | TPS62821DLCR | TI(德州仪器) | C469860 | LCSC
39 | 1 | TPS63900DSKR | U15 | WSON-10_L2.5-W2.5-W0.50-TL-EP |  | TPS63900DSKR | TI(德州仪器) | C1518762 | LCSC
40 | 1 | WAFER-PH2.0-2PWZ | U16 | CONN-TH_2P-P2.00_GP01-2001WR-2P |  | WAFER-PH2.0-2PWZ | XUNPU(讯普) | C5359610 | LCSC
41 | 1 | TYPE-C 16PIN 2MD(073) | USB1 | USB-C-SMD_TYPE-C-6PIN-2MD-073 |  | TYPE-C 16PIN 2MD(073) | SHOU HAN(首韩) | C2765186 | LCSC
