nikki-uwu/Meower/images/Silly_testing_setup.jpg

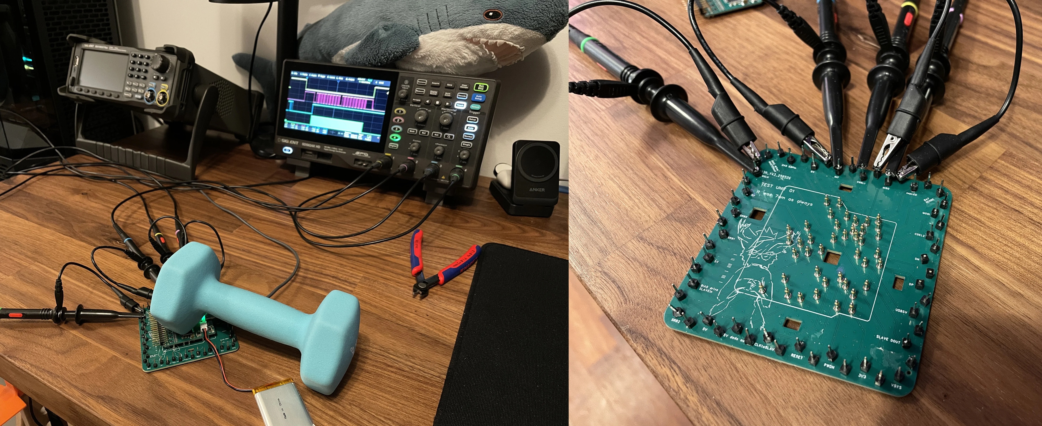
images/Silly_testing_setup.jpg
