nikki-uwu/Meower/images/Runtime measurements.PNG

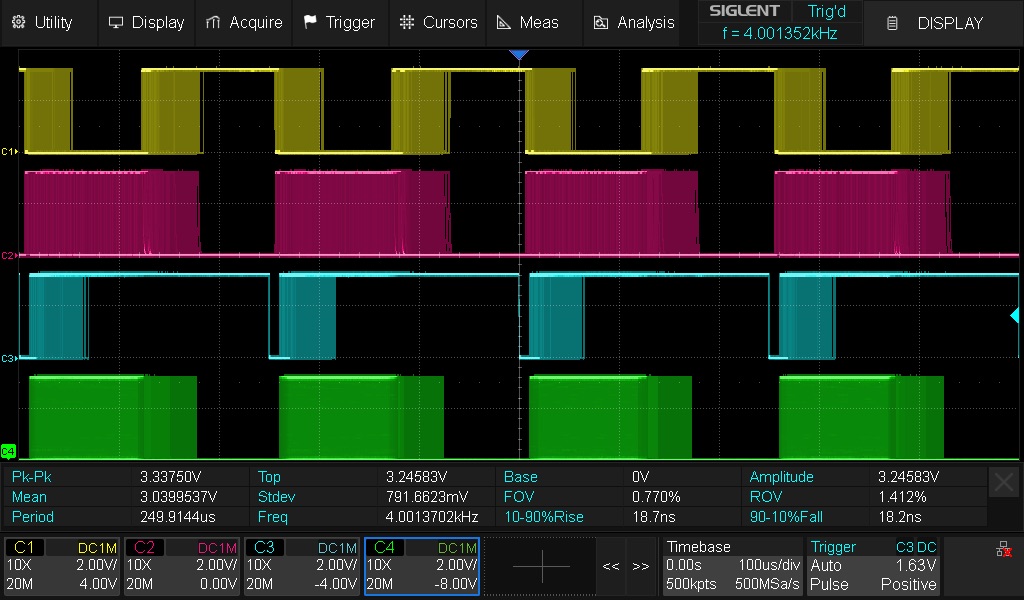
images/Runtime measurements.PNG
