nikki-uwu/Meower/hardware/meower_V1/SCH_BCI_ADS1299_2026-03-26.pdf

USB-C + FUSE | LiPo charger / LED status
| Charging current is 400 mA. 500 mA is max for this chip

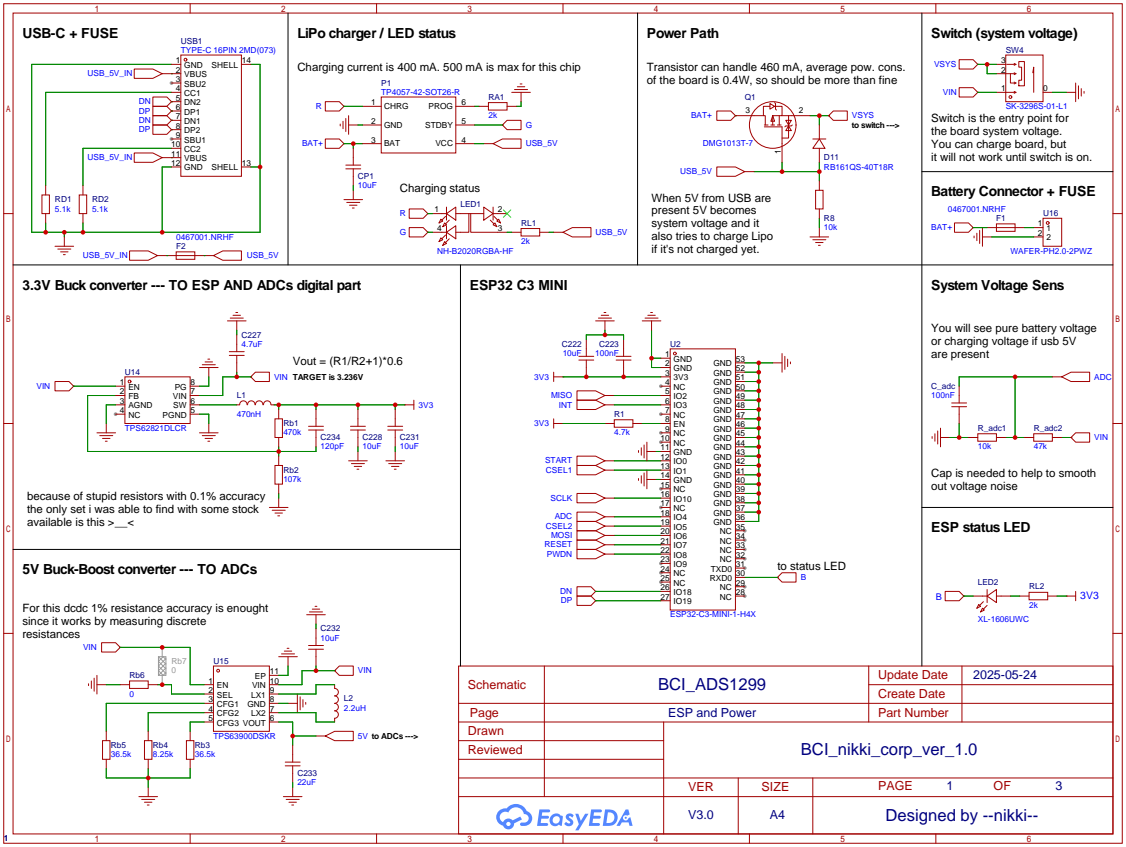
[picture p21: page 1]

Transistor can handle 460 mA, average pow. cons.
of the board is 0.4W, so should be more than fine

VIN
Switch is the entry point for
the board system voltage.
You can charge board, but
it will not work until switch is on.
Battery Connector + FUSE
0467001.NRHF
BAT+

RB161QS-40T18R USB_5V
When 5V from USB are
present 5V becomes
system voltage and it
also tries to charge Lipo
if it's not charged yet.

3.3V Buck converter --- TO ESP AND ADCs digital part

You will see pure battery voltage
or charging voltage if usb 5V
are present

Cap is needed to help to smooth
out voltage noise

because of stupid resistors with 0.1% accuracy
the only set i was able to find with some stock
available is this >__<

5V Buck-Boost converter --- TO ADCs

For this dcdc 1% resistance accuracy is enought
since it works by measuring discrete
resistances

# BCI_nikki_corp_ver_1.0

2025-05-08

# BCI_ADS1299

## ADCs

## Reviewed

## Drawn

## Create Date Part Number

## Schematic

## Update Date

## Page

IN8N
IN8P
IN7N
IN7P
IN6N
IN6P
IN5N
IN5P
IN4N
IN4P
IN3N
IN3P
IN2N
IN2P
IN1N
IN1P

C20
1uF

C19
1uF

C17
100nF

VREFP

C21
100uF

Cbias4

1.5nF RBIAS1

1M

AVDD

AVDD

C22
1uF

C23
100nF

AVDD

DVDD

here clockselect is DVDD
to have it set to one to
have it later as CLK output for secondary ADC

C25
100nF

C27
100nF

AVDD

AVDD

BIAS_DRV

C18
10uF

C26
10uF

C24
1uF

C28
100nF

C29
1uF

MOSI

SCLK

MISO

INT

PWDN

RESET

IN8N 1
IN8P 2
IN7N 3
IN7P 4
IN6N 5
IN6P 6
IN5N 7
IN5P 8
IN4N 9
IN4P 10
IN3N 11
IN3P 12
IN2N 13
IN2P 14
IN1N 15
IN1P 16
SRB1 17
SRB2 18
AVDD 19
AVSS 20
AVDD 21
AVDD 22
AVSS 23
VREFP 24
VREFN 25
VCAP4 26
NC 27
VCAP1 28
NC 29
VCAP2 30
RESV1 31

AVSS 32 DGND 33 DIN 34 PWDN# 35 RESET# 36 CLK 37 START 38 CS# 39 SCLK 40 DAISY_IN 41 GPIO1 42 DOUT 43 GPIO2 44 GPIO3 45 GPIO4 46 DRDY# 47 DVDD 48 DGND 49 DVDD 50 DGND 51 CLKSEL 52 AVSS1 53 AVDD1 54 VCAP3 55 AVDD 56 AVSS 57 AVSS 58 AVDD 59 BIASREF 60 BIASINV 61 BIASIN 62 BIASOUT 63 RESERVED 64

ADC2

ADS1299IPAGR

IN8N1
IN8P1
IN7N1
IN7P1
IN6N1
IN6P1
IN5N1
IN5P1
IN4N1
IN4P1
IN3N1
IN3P1
IN2N1
IN2P1
IN1N1
IN1P1
SRB11
SRB21

C30
1uF

C31
1uF

C32
100nF

VREFP1

C33
100uF

AVDD

AVDD

C34
1uF

C35
100nF

AVDD

DVDD

C36
100nF

C37
100nF

AVDD

AVDD

C38
10uF

C39
10uF

C40
1uF

C41
100nF

C42
1uF

MOSI

SCLK

PWDN

RESET

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

ADC1

ADS1299IPAGR

BIASINV | BIASINV
AVDD | 5V
PINSRB2

SRB2

SRB1

PINSRB22
PINSRB1 | PINSRB11

Cbias3
1.5nF

RBIAS4
1M
CLK | CLK
START | START

SLAVE_DOUT

SLAVE_DOUT

DVDD | 3V3
CSEL1 | CSEL2

BIASOUT and BIASIN are shorted, because BIASIN is going towards mux right away. So as i understood if BIASIN is off MUX will not use BIAS voltage to shift signal from 0 to
as i undestood positive AVDD/2. For unipolar powering AVSS is equal to 0 and it means it's just GROUND.
Check 9.2 Functional Block Diagram for BIASIN

# FOR UNIPOLAR POWERING SCHEME AVSS IS 0 - BASICALY GND AS WELL AS DIGITAL GROUND

Hi Mojtaba,
I'll try to be more clear.
Q: in total what does the BIASIN pin do and whats it's role?
A: In the event that the BIAS electrode becomes disconnected from the patient,
by having BIASOUT connected to BIASIIN, the BIASOUT signal can be routed through BIASIN and back to the patient through one of the input electrodes. This way, the patient stays biased and the measurements stay within the common-mode input range of the PGA. Of course, one measurement will be "lost" since it's being used to bias the patient.
Q: it should be done in both cascade or daisy chain mode or it's just for daisy chain?
A: it's the same for both modes.

# RANDOM KNOWLEDGE

It;'s important to keep decoupling capacitors
for all power pins. You can combine several pins
ino one decoupling capacitor output if they are supa close to eachother.
But in general - Datasheet says to have decopling cap for all of them - 1uf and 0.1uF

This is a very interesting problem! Let me first explain what the SRB pins do and what the BIAS pin does. The SRB pins are essentially inputs for a reference input that you intend to connect to multiple channels.
The SRB2 pin can be connected to individual channels' positive inputs.
The SRB1 pin can be connected to all channels' negative inputs.
The BIAS pin is the equivalent of a right-leg driver for an ECG measurement. It will output a signal that attempts to keep the patient's common-mode voltage within the valid range for the ADC.
This datasheet was actually just updated with a helpful section that discusses the various functions of these pins. You can find it here starting on page 65. In your case, though, since it is intended to be so modular, I recommend
you simply connect all INxN inputs to analog ground (assuming you are
using bipolar supplies) and find each electrode voltage in a single-ended
fashion. Then you can average each sample to calculate a "reference voltage" to then analyze each individual channel.

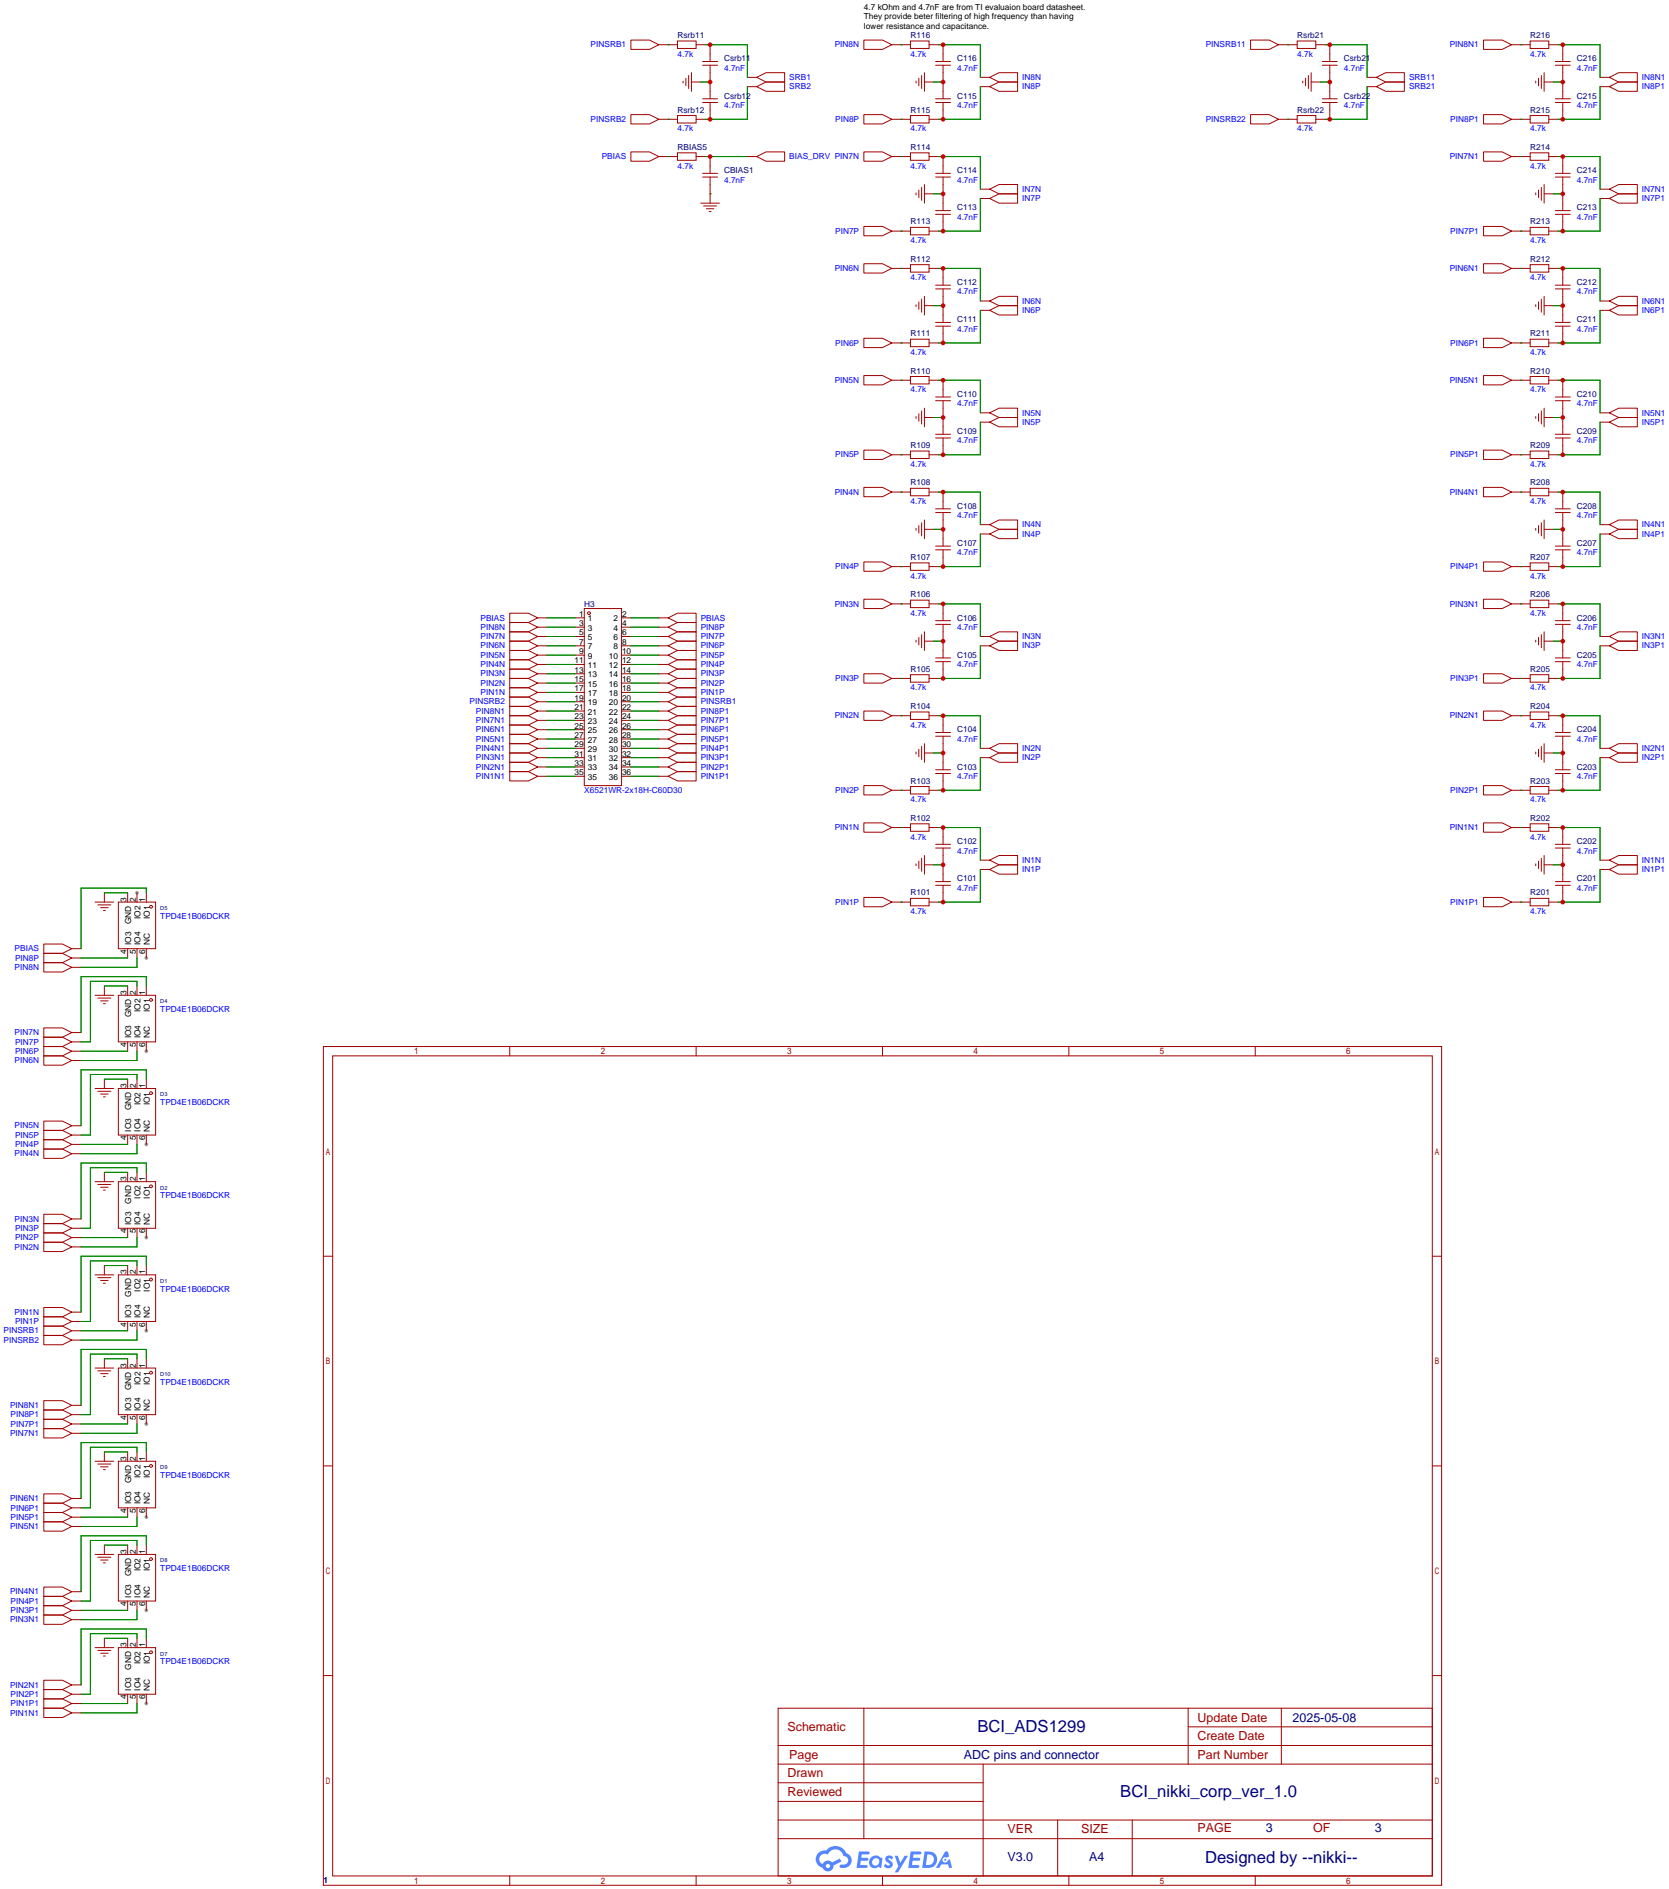
[picture p22: page 3]

4.7 kOhm and 4.7nF are from TI evaluaion board datasheet.
They provide beter filtering of high frequency than having
lower resistance and capacitance.
PIN8N

ADC pins and connector
