nikki-uwu/Meower/(list of files, drawings)

Other design files:
hardware/meower_Active_Electrode_V1.1/nikki_active_electrode_1.1.eprj
hardware/meower_Active_Electrode_V1/nikki_active_electrode_1.0.eprj
