nikki-uwu/Meower/src/main.cpp

// SPDX-License-Identifier: MIT OR Apache-2.0
// Copyright (c) 2025 Gleb Manokhin (nikki)
// Project: Meower

#include <Arduino.h>
#include <WiFi.h>
#include <WiFiUdp.h>
#include <SPI.h>
#include <helpers.h>
#include <defines.h>
#include <spi_lib.h>
#include <messages_lib.h>
#include <net_manager.h>
#include <math_lib.h>
#include <ap_config.h>
#include <Preferences.h>
#include <serial_io.h>




// Initialize variables and classes we need for main loop
// ---------------------------------------------------------------------------------------------------------------------------------
// ---------------------------------------------------------------------------------------------------------------------------------
NetManager net;
SPIClass spi(SPI);                 // Use the default SPI instance on the ESP32-C3

// Classes
Battery_Sense BatterySense(PIN_BAT_SENSE, BAT_SCALE, BAT_SAMPLING_MS); // defaults: GPIO-4, scaling 0.00428, 1000 ms (1 s) between battery sampling
Blinker       LEDheartBeat(PIN_LED      , LED_PERIOD_MS  ); // GPIO-20, 250 ms ON (chech defines), 5000 ms period
BootCheck     bootCheck;
Debugger      Debug(Serial, SERIAL_BAUD);   // even tho just one hardware Serial will be used kind of anyway, we are just telling explicetly we use hardware serial provided by ESP and same baud speed
SerialCli     CLI(Serial, SERIAL_BAUD);     // even tho just one hardware Serial will be used kind of anyway, we are just telling explicetly we use hardware serial provided by ESP and same baud speed

// FreeRTOS handles
static TaskHandle_t  adcTaskHandle = nullptr;
static QueueHandle_t adcFrameQue   = nullptr; // Processed ADC packet with multiple frames (frames+timestamps); battery added later in transmission task
QueueHandle_t        cmdQue        = nullptr;
static MsgContext    msgCtx;

// Dynamic packet sizing to maintain ~50 FPS over WiFi
// These variables are updated in continuous_mode_start_stop() when sampling rate changes
volatile uint32_t g_framesPerPacket = DEFAULT_FRAMES_PER_PACKET;  // Number of ADC frames to pack per UDP packet (5 frames at startup for 250 Hz = 50 FPS)
volatile uint32_t g_bytesPerPacket  = ADC_FULL_FRAME_SIZE * DEFAULT_FRAMES_PER_PACKET;     // Size in bytes of ADC data portion only (frames * 52 bytes each)
volatile uint32_t g_udpPacketBytes  = (ADC_FULL_FRAME_SIZE * DEFAULT_FRAMES_PER_PACKET) + Battery_Sense::DATA_SIZE; // Total UDP payload size (ADC data + 4-byte battery voltage)

// Lookup table: sampling rate -> frames to pack for ~50 FPS
const uint32_t FRAMES_PER_PACKET_LUT[5] = {  5 ,  //  250 Hz:  250/ 5 = 50 FPS exactly
                                            10 ,  //  500 Hz:  500/10 = 50 FPS exactly  
                                            20 ,  // 1000 Hz: 1000/20 = 50 FPS exactly
                                            28 ,  // 2000 Hz: 2000/28 = 71.4 FPS (max packing)
                                            28 }; // 4000 Hz: 4000/28 = 142.8 FPS (max packing)

// continuous reading mode state and maximum time we will wait before resseting mode if anything happened and ADC give no data back
volatile bool continuousReading = false;

// Timer counter for main loop, so we can control how often it's executed. Default is 1 time per 50 ms
static uint32_t previousTime = 0; // timer for main loop

// Digital gain. If signal you analyze uses maximum +-0.2V or any other value you better to
// amplify it so it uses the entire dynamic range of 24 bits.
// Gain made as bit shoft operation so we can get 1, 2, 4, 8, 16 and so on times which means 0, 1, 2, 3 bit shift and so on
// GAIN WILL SATURATE AND CORRUPT SIGNAL IF DYNAMIC RANGE AFTER GAIN IS BIGGER THAN sint32
volatile uint32_t g_digitalGain = 0; // Number of bits to shift, i.e. s = s << g_digitalGain

// Select between 50-100Hz (0) and 60-120Hz modes for notch filters. Mostly useful for sample rates upt to 500 Hz,
// but still works upto 4000 Hz
// [50-100 60-120] Hz
// [     0      1] select number
volatile uint32_t g_selectNetworkFreq = 0;

// Select for current working sampling frequency. It's needed for filters to set proper coefficients
// [250 500 1000 2000 4000] Hz
// [  0   1    2    3    4] select number
volatile uint32_t g_selectSamplingFreq = 0; // Sampling rate selector index

// Select cutOff frequency for DC filter.
// So, just in case, 0.5 Hz second order IIR for DC falls apart even with 32 bit coefficients and 32 bit signal.
// I've tried a lot of things and scaling signal by 8 bits for processing to always have 32 bit occupied and
// adding digital gain to push it even firther if signal itself never uses more then 16 bits for example, but still
// there are limits and 0.5 Hz at 4000 Hz sample rate is not stable and does not work really well - spkies can become permanent like
// resonator, you dont delete DC, you just inver it instead.
// So here you are - several cutoff frequencies you can choose from. Hope at least someone find it useful.
// [0.5 1 2 4 8] Hz
// [  0 1 2 3 4] select number
volatile uint32_t g_selectDCcutoffFreq = 0;

// ADC equalizer master switch. The SYS commands FILTER_EQUALIZER_ON / FILTER_EQUALIZER_OFF toggle it at run time.
volatile bool g_adcEqualizer = false;

// IIR (DC removal) master switch. The SYS commands FILTER_DC_ON / FILTER_DC_OFF toggle it at run time.
volatile bool g_removeDC = false;

// IIR 50/60 Hz notch filter master switch. The SYS commands FILTER_5060_ON / FILTER_5060_OFF toggle it at run time.
volatile bool g_block5060Hz = false;

// IIR 100/120 Hz notch filter master switch. The SYS commands FILTER_100120_ON / FILTER_100120_OFF toggle it at run time.
volatile bool g_block100120Hz = false;

// Global switch for all filters being ON or OFF
volatile bool g_filtersEnabled = false;




// Helpers
// ---------------------------------------------------------------------------------------------------------------------------------
// ---------------------------------------------------------------------------------------------------------------------------------
// Reads ONE complete command datagram from the queue.
// Returns the byte count (0 if none).  Mirrors the old signature so
// message_lib.cpp stays untouched.
int32_t udp_read(char* buf, size_t cap)
{
    if (!buf || cap == 0) return 0;
    if (xQueueReceive(cmdQue, buf, 0) == pdTRUE)
        return strnlen(buf, cap);
    return 0;
}




// TASKS
// ---------------------------------------------------------------------------------------------------------------------------------
// ---------------------------------------------------------------------------------------------------------------------------------
// DRDY interrupt for ADC task
// Called **automatically** the very moment the ADS1299’s DRDY pin makes a LOW transition
// (FALLING edge) - because in `setup()` you did:
//     attachInterrupt(PIN_DRDY, drdy_isr, FALLING);
//
// Timing constraints
// -------------------
// - DRDY goes LOW once per conversion (500 Hz → every 2 ms, 4 kHz → every 250 µs).
// - The ISR must finish extremely quickly (< 10-15 us) so we do *not* read SPI here.
//   All heavy lifting is delegated to a FreeRTOS task; the ISR’s only job is to wake it.
//
void IRAM_ATTR drdy_isr() // IRAM_ATTR: place code in IRAM, not flash -> no cache miss
{
    // Prepare a flag that tells FreeRTOS whether a higher-priority task unblocked
    // hp == pdTRUE  ->  the scheduler should run immediately after this ISR
    // hp == pdFALSE ->  it can wait until the next tick
    BaseType_t hp = pdFALSE;

    // Atomically increments the “notification value” that belongs to adcTaskHandle (ADC task).
    // If that task was blocked on ulTaskNotifyTake(), it becomes Ready.
    // If the ADC task’s priority ≥ the one that was interrupted, hp is set to pdTRUE.
    vTaskNotifyGiveFromISR(adcTaskHandle, &hp); // A task notification is a built-in counting semaphore—lighter and 45 % faster than a classic xSemaphoreGiveFromISR().
    
    // Perform an *immediate* context switch only when necessary
    // (i.e. when the ADC task outranks whatever task was interrupted).
    // This means the ADC task can start poking the SPI bus within ~5 µs after DRDY fell.
    if (hp)
    {
        // portYIELD_FROM_ISR() tells FreeRTOS:
        // “when you exit the current exception frame, switch to the
        // highest-priority Ready task instead of returning to the interrupted task”
        portYIELD_FROM_ISR();
    }
    
    // On exit the CPU automatically re-enables interrupts and continues running
    // the selected task.
}

// ADC continuous frame pulling and Signal processing.
// Why like this? because then we do not have to pass data vectors from ADC to UDP task
// which were taking too much time and stallking device and cause at some points
// frame loss from wifi side (wifi task were to slow)
// The ADC task queues multiple frames to adcFrameQue.
// DSP packs FRAMES_PER_PACKET (N) frames and later hands the full datagram to the network task.
void IRAM_ATTR task_getADCsamplesAndPack(void*)
{
    // Prelocate tx empty data with zeros for ADC sample read (we are sending zeros and ADC gives us back samples)
    const uint8_t tx_mes[ADC_SAMPLES_FRAME] = {0};

    // Raw ADC data from SPI
    // we need it separately to parse sample and remove two preambles from it, so we can have 48 bytes per one raw ADC frame instead of 54 
    static uint8_t rawADCdata[ADC_SAMPLES_FRAME];

    // Parsed ADC frame without preambles
    static uint8_t parsedADCdata[ADC_PARSED_FRAME];

    // Buffer to store up to MAX_FRAMES_PER_PACKET frames with timestamps
    // Each frame: [48 Bytes ADC data][4 Bytes timestamp] = 52 bytes
    static uint8_t dataBuffer[ADC_FULL_FRAME_SIZE * MAX_FRAMES_PER_PACKET];

    // Buffer for unpacked ADC samples from 24 to 32 bits which we will use for processing
    static int32_t dspBuffer[NUMBER_OF_ADC_CHANNELS] = {0};

    // We need to know if we were in continuous mode each loop.
    // If yes we just go as usual
    // If not and continuous mode started we must clean all internal buffers so data there is fresh
    bool wasReading = false;

    // Bytes counter - how many we already wrote and it also works as index.
    // First value is 0, then we move it by ADC_FULL_FRAME_SIZE, then again by ADC_FULL_FRAME_SIZE and so on
    uint32_t bytesWritten = 0u;

    // Start infinite loop
    for (;;) // Endless loop - a FreeRTOS task never returns.
    {
        // If we just started continuous mode we must clear all internal variables and buffers
        if (continuousReading && !wasReading)
        {
            ulTaskNotifyTake(pdTRUE, 0); // clear stale notify count

            // Reset cursor - next packet starts at byte 0
            bytesWritten = 0;
        }

        // store whether we were continuously reading or not for the next frame
        wasReading = continuousReading;
        
        // Wait until ADC pulls DRDY down (adc samples are ready to read)
        // We will wait here forever
        ulTaskNotifyTake(pdTRUE       ,  // clear on exit
                         portMAX_DELAY); // no timeout, hangs for ever

        // Write timestamp (4 bytes) into the buffer at the end of the channel data for this frame.
        // - We use memcpy here (instead of casting uint8_t* to uint32_t*) because:
        //   (1) The offset into the buffer (bytesWritten + ADC_PARSED_FRAME) must be divisible by 4,
        //   (2) The base address of dataBuffer itself must also be 4-byte aligned.
        //   If either is not guaranteed, pointer casting is unsafe on some MCUs (may cause alignment faults).
        // - memcpy is always safe, even if alignment or buffer padding is not guaranteed.
        // - The timestamp sits directly after the 48 bytes of channel data, at offset +48 in each frame.
        // - Suitable for real-time use, provides low-latency timestamping.
        uint32_t timeStamp = getTimer8us(); // 8us timer
        memcpy(&dataBuffer[bytesWritten + ADC_PARSED_FRAME], &timeStamp, sizeof(timeStamp));

        // If we are in continuous mode - do stuff if not - do nothing at all
        if (continuousReading)
        {
            // Get ADC samples
            // We are sending SPI messages with zeros to ADCs and ADCs give us back samples one by one in return
            // Here both master and slave should have Chip Select active
            xfer('B', ADC_SAMPLES_FRAME, tx_mes, rawADCdata);

            // Now let's remove two preambles from raw ADC frame, it will save us 6 bytes and we can pack more frames together because of that
            removeAdcPreambles(rawADCdata, parsedADCdata);

            // Unpack all smaple to 32 bits, left-shift by 8 bits (multiply by 256) to
            // let signal use full dynamic range of a signed 32-bit integer and apply digital gain.
            // It's needed to preserve as much dynamic range as possible.
            // I added constant 8 bit shoft after filters started to fall apart on higher sampling rates because
            // keeping signal at 24 bits without moving up and 31 bits coeefficients is just
            // not enough unfortunately
            // Unpack is also here outside of filters chain since we have digital gain, which means we have to run it every time.
            // Digital gain can help to reduce precision errors for filters and processing even more.
            // It's advised to use as high gain as possible if signal does not occupy the entire +-4.5V range (all 24 bits)
            unpack_24to32_and_gain(parsedADCdata, dspBuffer, g_digitalGain);

            // Filtering
            // BYPASS if global for all filters is OFF
            // --------------------------------------------------------------------------------------------
            adcEqualizer_16ch_7tap(dspBuffer,                                             g_adcEqualizer  && g_filtersEnabled); // if we need adc frequency response equalizer - filter data using FIR with 7 taps
            dcBlockerIIR_16ch_2p  (dspBuffer, g_selectSamplingFreq, g_selectDCcutoffFreq, g_removeDC      && g_filtersEnabled); // Remove DC
            notch5060Hz_16ch_4p   (dspBuffer, g_selectSamplingFreq, g_selectNetworkFreq , g_block5060Hz   && g_filtersEnabled); // Notch filter for 50/60 Hz
            notch100120Hz_16ch_4p (dspBuffer, g_selectSamplingFreq, g_selectNetworkFreq , g_block100120Hz && g_filtersEnabled); // Notch filter for 100/120 Hz

            // Pack all samples back to 24 bits with scaling them back by 8 bits (>>8 or /256).
            // Shift by 8 was added to signal to occupy full dynamic range of int32 during unpacking
            pack_32to24(dspBuffer, parsedADCdata);

            // Copy one processed (or raw, if filters are off) ADC frame (16 channels × 24 bits = 48 bytes),
            // where the timestamp (4 bytes) has already been appended at the end in dataBuffer.
            // Each frame totals 52 bytes in the packet; memcpy writes only the 48 bytes of channel data here.
            memcpy(&dataBuffer[bytesWritten], // Write pointer for next frame in datagram
                   parsedADCdata,             // Source: 48 bytes of processed or raw channel data
                   ADC_PARSED_FRAME);         // Number of bytes to copy: 48 (no timestamp, just data)

            // Increment amount of writen bytes (which also means frames).
            // this way we can count and also move pointer so next ADC frame will be writen nicely right after this one.
            bytesWritten += ADC_FULL_FRAME_SIZE;

            // Is the data buffer now exactly full?
            if (bytesWritten >= g_bytesPerPacket)
            {
                // Send one complete packet (ADC frames + time-stamps) to Wi-Fi task.
                // Battery voltage is merged in the UDP task just before transmission.
                xQueueSend(adcFrameQue,    // queue handle
                           dataBuffer,     // pointer to packet
                           0); // wait if both slots are full in que. It means if UDP never reads from que DSP will stay here forever. DSP is not allowed to write to que if que is full

                // Reset cursor - next packet starts at byte 0
                bytesWritten = 0;
            }
        }

        #ifdef DEBUG
            // test signal to see when our task got it done so you can see it on oscilloscope.
            // This is test signal, all chips selects are deactivated
            uint8_t ADC_data_out = 0;
            uint8_t dummyByte    = 0;
            xfer('T', 1, &dummyByte, &ADC_data_out);
        #endif
    }
}

// Data sender task
// This network task runs over Wi-Fi and doesn’t need to be hard real-time.
// Putting it in IRAM wastes space needed for critical routines.
// IRAM code runs without touching flash, but this task will go back to flash anyway.
// Flash fetches can be blocked during Wi-Fi or SPI1 use, causing unexpected delays.
// If the task lives in IRAM, those stalls can even crash or hang it.
// Keeping non-critical tasks in flash makes behavior more predictable.
// It also leaves IRAM free for ISRs and DSP loops that truly need zero-wait execution.
// Only put the fastest, most time-sensitive code into IRAM.
void task_dataTransmission(void*)
{
    // Pre-allocate buffer sized for maximum possible UDP payload
    // Actual usage varies: 264 bytes (250Hz) to 1460 bytes (2kHz/4kHz)
    // Buffer must handle worst case: 28 frames * 52 bytes + 4 byte battery = 1460 bytes
    static uint8_t txBuf[ADC_FULL_FRAME_SIZE * MAX_FRAMES_PER_PACKET + Battery_Sense::DATA_SIZE];

    // Start infinite loop
    for (;;) // Endless loop - a FreeRTOS task never returns.
    {
        // wait forever until DSP overwrites mailbox with a new set of processed frames
        xQueueReceive(adcFrameQue, txBuf, portMAX_DELAY);

        // Append the latest battery voltage (4-byte float)
        Battery_Sense::value_t vbatt = BatterySense.getVoltage();
        memcpy(&txBuf[g_bytesPerPacket], &vbatt, Battery_Sense::DATA_SIZE);
        
        // Send if peer active
        if (net.wantStream())
            net.sendData(txBuf, g_udpPacketBytes);
    }
}

// Main loop and Setup
// ---------------------------------------------------------------------------------------------------------------------------------
// ---------------------------------------------------------------------------------------------------------------------------------
// Setting up pins, wifi connection, reset ADC at the start of the board and initialize ADC and wifi tasks
void setup()
{
    // Run Serial - Serial as object is project wise defined object provided by ESP
    // that is why we can call it this way without declare anywhere
    Serial.begin(SERIAL_BAUD);
    Debug.begin();               // no baud arg needed, prints banner
    CLI.begin();                 // prints CLI banner
    delay(10);

    // bootCheck controlls hard reset to access point mode.
    // if we turned on/off board several time in 5 seconds it will force board
    // to jump in Access Point mode instead of normal mode even if WiFi
    // data was setted up correctly
    bootCheck.init();

    // Start AP mode if we hard switch reset or no wifi data present
    maybeEnterAPMode();

    // If settings are found - pull WiFi credentials and ports from memory
    // PC IP will be auto-discovered via MEOW_MEOW/WOOF_WOOF beacon exchange
    Preferences prefs;
    bool netconf_ok = prefs.begin("netconf", true);  // try read-only

    if (!netconf_ok)
    {
        Debug.print("[BOOT] netconf namespace not found - creating");
        prefs.end();  // always close before re-opening

        if (prefs.begin("netconf", false))  // open write-mode
        {
            prefs.putString("ssid"     , "");
            prefs.putString("pass"     , "");
            prefs.putUShort("port_ctrl", 0 );
            prefs.putUShort("port_data", 0 );
            prefs.end();  // close after write
            prefs.begin("netconf", true);  // reopen as read-only for rest of setup
        }
        else
        {
            Debug.print("[BOOT] Failed to create netconf NVS - staying in AP mode");
            prefs.end();
            return;
        }
    }

    // NOW: safely read all values
    String   ssid      = prefs.getString("ssid", "");
    String   pass      = prefs.getString("pass", "");
    uint16_t port_ctrl = prefs.getUShort("port_ctrl");
    uint16_t port_data = prefs.getUShort("port_data");

    prefs.end();

    if (ssid.isEmpty())
    {
        Debug.print("[WIFI] No SSID set - entering AP mode");
        Preferences bm;
        if (bm.begin("bootlog", false))          // write-mode
        {
            bm.putString("BootMode", "AccessPoint");
            bm.end();
        }

        ESP.restart();                      // blocks forever
    }


    // Configure Wi-Fi using saved credentials and ports
    // PC IP will be auto-discovered when PC responds with WOOF_WOOF to our MEOW_MEOW beacon
    net.begin(ssid.c_str(), pass.c_str(), port_ctrl, port_data);

    // CONFIGURE SPI PINS
    pinMode(PIN_SCLK     , OUTPUT);
    pinMode(PIN_MOSI     , OUTPUT);
    pinMode(PIN_MISO     , INPUT );
    pinMode(PIN_DRDY     , INPUT ); // DATA-READY PIN or INT PIN
    pinMode(PIN_CS_UNUSED, OUTPUT);
    digitalWrite(PIN_CS_UNUSED, HIGH); // Deactivate default (unused) CS pin

    // CONFIGURE NEW CS PINS FOR MASTER & SLAVE ADS1299
    pinMode(PIN_CS_MASTER, OUTPUT);
    pinMode(PIN_CS_SLAVE , OUTPUT);
    digitalWrite(PIN_CS_MASTER, HIGH); // Deactivate master CS by default
    digitalWrite(PIN_CS_SLAVE , HIGH); // Deactivate slave CS by default

    // START PIN ---
    pinMode(PIN_START, OUTPUT);
    digitalWrite(PIN_START, LOW);

    // CONFIGURE REST AND POWER DOWN PINS
    pinMode(PIN_PWDN , OUTPUT);
    pinMode(PIN_RESET, OUTPUT);
    digitalWrite(PIN_PWDN , HIGH); // Power down chip if LOW
    digitalWrite(PIN_RESET, HIGH); // Reset chip if LOW

    // INITIALIZE SPI
    // On ESP32-C3, you can override the default pins with:
    spi.begin(PIN_SCLK, PIN_MISO, PIN_MOSI, PIN_CS_UNUSED);

    // Now lets handle spi handle to SPI lib and helpers
    spi_init(&spi);

    // GET RID OF TRI-STATE FOR MISO, so signal does not decay slowly if last bit was equal to 1
    pinMode(PIN_MISO, INPUT_PULLDOWN);

    // Set SPI clock to 2 MHz for commands and switch off continuous mode
    continuous_mode_start_stop(LOW);

    // Configure LED pin
    pinMode(PIN_LED, OUTPUT);          // make it an output
    digitalWrite(PIN_LED, LOW);        // start OFF

    WiFi.setSleep(true);               // let the modem nap between DTIM beacons

    wifi_config_t cfg;
    esp_wifi_get_config(WIFI_IF_STA, &cfg);
    cfg.sta.listen_interval = 1;
    esp_wifi_set_config(WIFI_IF_STA, &cfg);
    esp_wifi_set_ps(WIFI_PS_MAX_MODEM); // deepest power-save level while connected

    // hand sockets to the message parser
    msgCtx.udp              = net.udp(); // raw WiFiUDP
    msgCtx.spi              = &spi;
    msgCtx.udp_port_pc_ctrl = port_ctrl;
    msg_init(&msgCtx);

    // Just to be 100 % sure - locks the CPU clock to 160 MHz.
    // So, if clock here is not 80 Mhz anymore - reason to push 160 was to make sure, that
    // ADC and DSP task is so fast i still have a lot of overhead before next sample appears. And
    // based on what i've seen when i felt that processing is 99% ready - 160 MHz uses just maybe 30 mW more
    // in mormal mode. at 4000 Hz and max packing of data (28 frames) board was using 470 mW which is still
    // around 8+ hours of lifetime on 1100 mAh lipo. And for normal use it's 380 - 400 mW which is 10+ hours.
    // And for anyone who wants to use 4000 Hz - i don't think they need 10+ hours anyway.
    setCpuFrequencyMhz(160);

    // FreeRTOS resources
    // 5-slot queue that holds exactly 5 complete UDP datagrams.
    //
    // NOTE - This queue is not a read/write-collision guard.  The kernel
    //        already serialises access. The extra slots simply adds head-
    //        room: the ADC task keeps running even if the queue is FULL.
    //        it means ADC and processing are safe and sender task should
    //        catch up.
    //
    // Timing math:
    // - One 28-frame packet @500 SPS = 56 ms.
    // - 5 slots -> 280 ms breathing room before the ADC task must wait.
    //
    // Typical brief Wi-Fi stall or “woof-storm”:
    //   1) UDP task copies packet from slot 0 (queue locked while copying).
    //   2) Lock releases -> higher-priority ADC pre-empts and refills slot 0.
    //   3) If the stall persists, ADC writes the next packet into slot 1, 2, 3, 4.
    //      Queue now full -> ADC never blocks and continue the processing skipping putting frames inside
    //   4) UDP later drains slot 0, then slot 1 and so on - FIFO order guaranteed by
    //      FreeRTOS, no extra bookkeeping needed.
    //   5) Queue empty -> both tasks resume normal cadence; occasional
    //      overlaps handled transparently with zero frame loss.
    //
    // Blocking rules:
    //   - ADC and DSP task never blocks. If sender task is too slow and adc task cant write it will skip writing right away
    //   - Data Transmittion task blocks until at least one item is inside the que and if ADC/DSP task is running
    // Queue sized for worst case (28 frames)
    adcFrameQue = xQueueCreate(5,                                            // 5 packets buffer (content varies by sampling rate)
                               ADC_FULL_FRAME_SIZE * MAX_FRAMES_PER_PACKET); // size of one complete packet (max possible) - battery not included

    // Que for command from PC
    cmdQue = xQueueCreate(8,               // up to 8 in-flight commands
                          CMD_BUFFER_SIZE);   

    // High-priority task.
    // Reads every DRDY pulse, removes preambula from ADC data, processes samples, assembles FRAMES_PER_PACKET ADC frames with time stamps,
    // then sends data to the queue.
    xTaskCreatePinnedToCore(task_getADCsamplesAndPack, // entry point
                            "adc",                     // task name for debugging
                            2048,                      // stack (bytes) BASED ON REAL TEST WITH HIGH SPEED ADC USES AROUND 500 BYTES ONLY EVEN WITH 28 FRAMES PACKED
                            nullptr,                   // no task argument
                            configMAX_PRIORITIES - 1,  // almost top priority
                            &adcTaskHandle,            // handle needed by the ISR
                            0);                        // run on core 0

    // Lower-priority task: blocks on the queue, adds battery voltage, transmits packet via Wi-Fi/BLE.
    // Separated from the ADC and DSP tasks -> so slow networking cannot stall sampling and processing.
    xTaskCreatePinnedToCore(task_dataTransmission,    // entry point
                            "sender",                 // task name
                            2048,                     // larger stack BASED ON REAL TEST WITH HIGH SPEED SENDER USES AROUND 500 BYTES ONLY EVEN WITH 28 FRAMES PACKED
                            nullptr,                  // no task argument
                            configMAX_PRIORITIES - 2, // just below the ADC task
                            nullptr,                  // we don’t need the handle later
                            0);                       // keep both tasks on the same core

    // DRDY line goes HIGH -> LOW at the end of every ADC conversion.
    // The ISR merely notifies the ADC task; all heavy SPI I/O happens in task context.
    attachInterrupt(PIN_DRDY,  // GPIO number
                    drdy_isr,  // ISR function (in IRAM)
                    FALLING ); // trigger on falling edge

    // Right at the end we have to reset ADC so it's at default state.
    ads1299_full_reset(); // Signal will be square wave with 1s period

    // IF we use it for BCI - do preset
    if (BCI_MODE) { BCI_preset(); } // Set normal BCI mode

    Debug.log("[BOOT] ssid      : %s", ssid.c_str());
    Debug.log("[BOOT] pass      : %s", pass.c_str());    // password is shown in plain text
    Debug.log("[BOOT] PC ip     : auto-discover via WOOF_WOOF");
    Debug.log("[BOOT] board ip  : %s", net.getLocalIP().toString().c_str());
    Debug.log("[BOOT] port_ctrl : %u", port_ctrl);
    Debug.log("[BOOT] port_data : %u", port_data);
}

// This loop will repeat again and again forever - yeah yeah, i wasn't supa used to esp programming :3
// ---------------------------------------------------------------------------------------------------------------------------------
// ---------------------------------------------------------------------------------------------------------------------------------
void loop()
{
    // Wait until between last loop start and this one exactly given amount of ms passed. Default is 50 ms
    uint32_t currentTime    = millis();                                           // get current time
    uint32_t timeDifference = MAIN_LOOP_PERIOD_MS - (currentTime - previousTime); // compare how much time passed since last loop and get how long to wait to get needed delay

    // If delay more than 0 ms AND less than period we need - wait.
    // Otherwise save current time and proceed
    if ((timeDifference > 0) && (timeDifference < MAIN_LOOP_PERIOD_MS))
    {
        delay(timeDifference);
    }
    else
    {
        previousTime = currentTime;
    }

    // LED heartbeat (writes to physical pin only on transitions)
    net.driveLed(LEDheartBeat);  // set pattern if state changed
    LEDheartBeat.update();       // update pin (non-blocking)
    BatterySense.update();       // Check battery voltage
    net.update();                // Beacon & housekeeping  

    // Always check for inbound control commands
    parse_and_execute_command();

    // boot - if 3 seconds passed remove reset flags
    bootCheck.update();

    // Check serial port for any incoming commands
    CLI.update();
}
