nikki-uwu/Meower/src/messages_lib.h

// SPDX-License-Identifier: MIT OR Apache-2.0
// Copyright (c) 2025 Gleb Manokhin (nikki)
// Project: Meower

#ifndef MESSAGES_LIB_H
#define MESSAGES_LIB_H

#include <WiFiUdp.h>   // WiFiUDP
#include <SPI.h>       // SPIClass
#include <stdint.h>
#include <net_manager.h>




// MsgContext  - shared pointers the parser needs (populated in main.cpp)
// ---------------------------------------------------------------------------------------------------------------------------------
// ---------------------------------------------------------------------------------------------------------------------------------
struct MsgContext
{
    WiFiUDP *    udp;         // raw socket for parser replies
    SPIClass *   spi;         // SPI handle if helpers need it
    uint16_t     udp_port_pc_ctrl; // PC UDP port
};




// API
// ---------------------------------------------------------------------------------------------------------------------------------
// ---------------------------------------------------------------------------------------------------------------------------------
void msg_init(const MsgContext *ctx);         // called from setup()
void parse_and_execute_command(void);         // called every loop()




// Family handlers (implemented in .cpp)
// ---------------------------------------------------------------------------------------------------------------------------------
// ---------------------------------------------------------------------------------------------------------------------------------
void handle_SPI(char **ctx, const char *orig);
void handle_SYS(char **ctx, const char *orig);
void handle_USR(char **ctx, const char *orig);  // placeholder

#endif // MESSAGES_LIB_H
