nikki-uwu/Meower/(commit log)

2025-06-22 adding python files i have for current processing
2025-06-22 comments, bugx, optimization previousTime is use only for main loop, no volatile based on datasheet for ads12 we need to pull start signal down only after SDATAC task_dataTransmission is outside of I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
    [main.cpp]
2025-06-23 reinit on switch ap config switch logic stupid boot check reasons for reboot integration into main
    [ap_config.cpp, helpers.cpp, helpers.h, main.cpp, messages_lib.cpp]
2025-06-24 comments on spi and transferBytes for all CS controls
2025-06-24 FIX for time check for keepalive getting overflowed
    [net_manager.cpp]
2025-06-26 more cleaning i'm lazy to describe- removed some variable, moved full reset to cpp. nothing which should brake code in any way
    [defines.h, helpers.cpp, helpers.h, main.cpp, net_manager.cpp, spi_lib.cpp]
2025-06-26 max input serial command length AP rework
    [ap_config.cpp, serial_io.cpp]
2025-07-04 I decided to switch to Q 35 for 50/60 and 100/120 hz filters to reduce ringing a bit and make them more stable
2025-07-04 small fix and debug
    [main.cpp, net_manager.h]
2025-07-09 new GUI for control. Basically ready, but processing is still broken
    [main_gui.py, serial_backend.py, signal_backend.py, udp_backend.py]
2025-07-11 EXTREMLY DENGEROUS ERROR WITH STATIC INSIDE LOOP WHERE VALUES SHOULD CHANGE ADC RESET went to helpers
    [helpers.cpp, helpers.h, main.cpp]
2025-07-15 added waiting for ads1299 to be ready before doing resets at the setup stage
    [helpers.cpp, helpers.h, main.cpp, messages_lib.cpp]
2025-07-15 Critical bugfix - let slave lock onto masters clock. i had no time delay between so slave could never fully wake while i already sending commands
    [helpers.cpp, messages_lib.cpp]
2025-07-15 bug fix with mean value
    [plot_manager.py]
2025-07-17 made board start stop methods with start/stop continious mode message and put floof flag as separate things
2025-07-17 i've realized it's better to keep all filters OFF by default.
2025-07-22 Removed IP config from GUI. Added stop continious mode for ADC reset
    [main_gui.py, messages_lib.cpp]
2025-07-23 Updates for auto framerate over wifi
2025-07-23 transition to auto framerate, bug fixes
    [defines.h]
2025-07-23 changes for auto framerate, bug fixes
    [helpers.cpp, helpers.h, main.cpp, math_lib.h, messages_lib.cpp, net_manager.h, serial_io.h, spi_lib.cpp]
2025-07-24 fixes and updates for GUI
    [main_gui.py, plot_manager.py]
2025-07-24 optimize spi clock handling
2025-07-24 SPI clock handling update
2025-07-24 SPI clock handling and new user message
2025-07-24 new default for battery
2025-07-24 updates for user commands and SPI handling
2025-07-29 hardware files are added :3
    [BOM_BCI_Board_2025-05-24.xlsx, BOM_CK-C3-Mini-085-4LY_PCB3_2025-05-24.xlsx, PickAndPlace_BCI_Board_2025-05-24.xlsx, PickAndPlace_PCB3_2025-05-24.xlsx]
2025-07-29 Hardware files relative updates. a big one but i'm lazy to take care of it, meow :3
    [BOM_BCI_Board_2025-05-24.xlsx, BOM_CK-C3-Mini-085-4LY_PCB3_2025-05-24.xlsx, PickAndPlace_BCI_Board_2025-05-24.xlsx, PickAndPlace_PCB3_2025-05-24.xlsx]
2025-08-07 req and dependecies and fix for broken gui and non grab bug
    [install_dependencies.py, main_gui.py, plot_manager.py, signal_backend.py]
2025-08-07 better AP mode, start with lower TX power, esp erase and port based on platformion pick
2025-08-07 power modes in defines
2025-08-07 no need to wait for second chip to wake up since we reset ADC fully anyway and the way to get it back will be full reset, so just one is enough
    [main.cpp]
2025-08-07 Start wifi at MIN power and only after begin pull it up to a normal mode.
2025-09-26 I've paniced and decided to make a warning for PCB orders
2025-10-03 Active electrode prototype is added - ordered test boards from JLCPCB
    [BOM_CK-C3-Mini-085-4LY_BCI_Board_2025-10-02.xlsx, PickAndPlace_BCI_Board_2025-10-02.xlsx]
2025-10-03 Added mention of active electrode to the readme
2025-10-03 Added new pictures and active electrode comments
2025-10-03 testing board image
2025-10-04 small rearrangement
    [BOM_CK-C3-Mini-085-4LY_BCI_Board_2025-10-02.xlsx, PickAndPlace_BCI_Board_2025-10-02.xlsx]
2025-10-21 added final version of an active electrode
    [nikki_active_electrode_1.0.eprj, nikki_active_electrode_1.1.eprj]
2026-03-26 added PDF and images inside
    [nikki_active_electrode_1.1.eprj]
2026-03-26 schematic looks AWFUL and even close to how i do that right now, but what ever. at least people will see PDF file
2026-03-26 same PDF, just to make sure we have it inside both folders for the active electrodes
2026-03-31 added order files for electrode v1.1
    [BOM_nikki_active_electrode_2026-03-31.xlsx, PickAndPlace_nikki_active_electrode_2026-03-31.xlsx]
